isoeth/CcSoM_ADC_Board/README.asciidoc

= README

== Description
CcSoM_ADC_Board is a Baseboard for the  
link:https://github.com/fsnitz/CcSoM[CcSoM]

== Features
CcSoM_ADC_Board main feature is the link:https://www.analog.com/en/products/ltc2242-12.html[LTC2242-12 12Bit ADC]. +
For sending information to the PC the Board includes: +
1x 1Gbit Ethernet (based on link:https://github.com/intergalaktik/Extension_Boards_for_Olimex_GateMate/tree/main/ethIO[Extension_Boards_for_Olimex_GateMate ethIO]) +
2x USB2 Interfaces 

== Manufacturing notes
The signal trace witdth to and from the adc to the connector is calculated for the +
Stackup: JLC041011-3313 (4 Layer, 1 PCBThickness, 1oz inner Copper Weight, 1oz Outer Copper Weight) +
used link:https://jlcpcb.com/pcb-impedance-calculator[calculator] +
50Ohm Single-ended: 0.1427 mm (for gbit ethernet traces) +
100Ohm differential: +
width:0.1016 mm; spacing:0.1524 mm (for ADC traces)

=== Component notes
These Components are discontinued on Digikey: 

* SN74LVC00APWE4 
* TPS73633DBVRG4 

== Project status
schematic and pcb has to be reviewed
