isoeth/CcSoM_ADC_Board/CcSoM_ADC_Board/CcSoM_ADC_Board.kicad_pcb

## KiCad design CcSoM_ADC_Board/CcSoM_ADC_Board.kicad_pcb (2026-04-17)

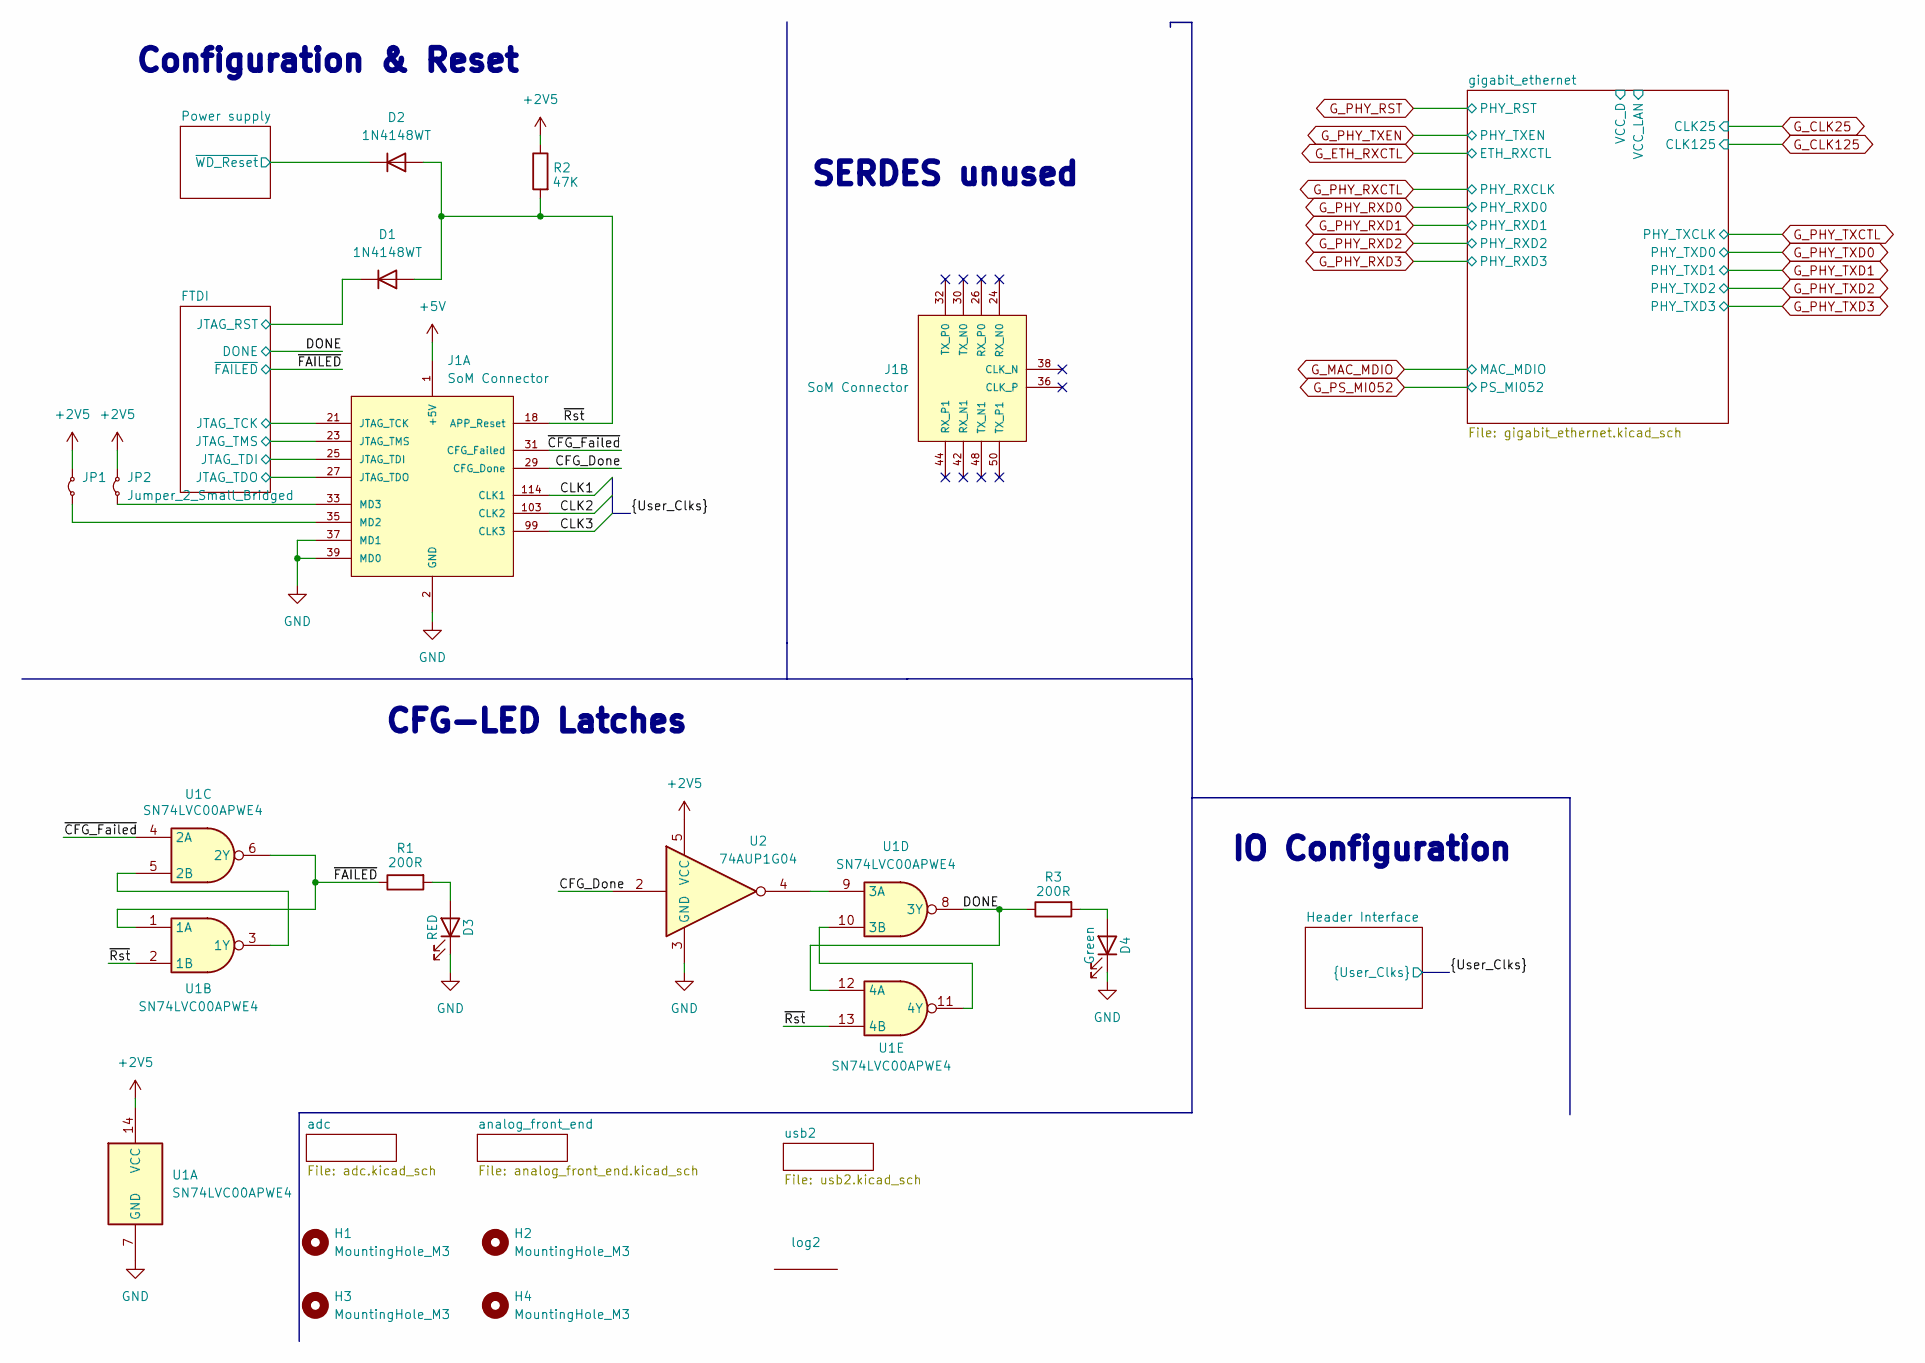
[picture p1: schematic CcSoM_ADC_Board.kicad_sch, SoM Programmer & ADC Board]

Parts:
D1, D2: 1N4148WT; LED_0603_1608Metric; Mouser Part Number 637-1N4148WT
D3: RED; LED_0603_1608Metric; Mouser Part Number 710-150060SS75000
D4: Green; LED_0603_1608Metric; Mouser Part Number 710-150060VS75000
H1, H2, H3, H4: MountingHole_M3; MountingHole_3.2mm_M3
J1: SoM Connector; SoM_Connector; Mouser Part Number 571-1-1473005-1
JP1, JP2: Jumper_2_Small_Bridged; TestPoint_2Pads_Pitch2.54mm_Drill0.8mm; DigiKey_no 664-G800W306018EU-ND
R1, R3: 200R; R_0603_1608Metric; Mouser Part Number 71-CRCW0603200RFKEC
R2: 47K; R_0603_1608Metric; Mouser Part Number 71-CRCW060347K0FKED
U1: SN74LVC00APWE4; TSSOP-14_4.4x5mm_P0.65mm; Mouser Part Number 595-SN74LVC00APWE4
U2: 74AUP1G04; SOT-23-5; Mouser Part Number 595-SN74AUP1G04DBVR
log2: OpenHardwareLogo

Connections:
+5V: J1.1 (+5V), J1.4 (+5V); also elsewhere on the board
/CFG_Done: J1.29 (CFG_Done), U2.2
/CLK1: J1.114 (CLK1)
/CLK2: J1.103 (CLK2)
/CLK3: J1.99 (CLK3)
/DONE: R3.1, U1.8 (3Y), U1.12 (4A); also elsewhere on the board
/FTDI/JTAG_RST: D1.1 (K); also elsewhere on the board
/FTDI/JTAG_TCK: J1.21 (JTAG_TCK); also elsewhere on the board
/FTDI/JTAG_TDI: J1.25 (JTAG_TDI); also elsewhere on the board
/FTDI/JTAG_TDO: J1.27 (JTAG_TDO); also elsewhere on the board
/FTDI/JTAG_TMS: J1.23 (JTAG_TMS); also elsewhere on the board
/Power supply/~WD_Reset: D2.1 (K); also elsewhere on the board
/~CFG_Failed: J1.31 (CFG_Failed), U1.4 (2A)
/~FAILED: R1.1, U1.1 (1A), U1.6 (2Y); also elsewhere on the board
/~Rst: D1.2 (A), D2.2 (A), J1.18 (APP_Reset), R2.2, U1.2 (1B), U1.13 (4B)
unnamed: D3.2 (A), R1.2
unnamed: D4.2 (A), R3.2
unnamed: J1.35 (MD2), JP1.2 (B)
unnamed: J1.33 (MD3), JP2.2 (B)
unnamed: U1.3 (1Y), U1.5 (2B)
unnamed: U1.9 (3A), U2.4
unnamed: U1.10 (3B), U1.11 (4Y)
OGND: D3.1 (K), D4.1 (K), J1.2 (GND), J1.3 (GND), J1.6 (GND), J1.7 (GND), J1.10 (GND), J1.11 (GND), J1.14 (GND), J1.15 (GND), J1.19 (GND), J1.20 (GND), J1.22 (GND), J1.28 (GND), J1.34 (GND), J1.37 (MD1), J1.39 (MD0), J1.40 (GND), J1.46 (GND), J1.52 (GND), J1.54 (GND), J1.97 (GND), J1.101 (GND), J1.105 (GND), J1.112 (GND), J1.116 (GND), J1.122 (GND), J1.144 (GND), J1.159 (GND), J1.162 (GND), J1.180 (GND), J1.181 (GND), J1.199 (GND), J1.S1 (SHIELD), J1.S2 (SHIELD__1), U1.7 (GND), U2.3 (GND); also elsewhere on the board
OVDD: JP1.1 (A), JP2.1 (A), R2.1, U1.14 (VCC), U2.5 (VCC); also elsewhere on the board

Notes on the sheet:
Configuration & Reset
CFG-LED Latches
IO Configuration
SERDES unused

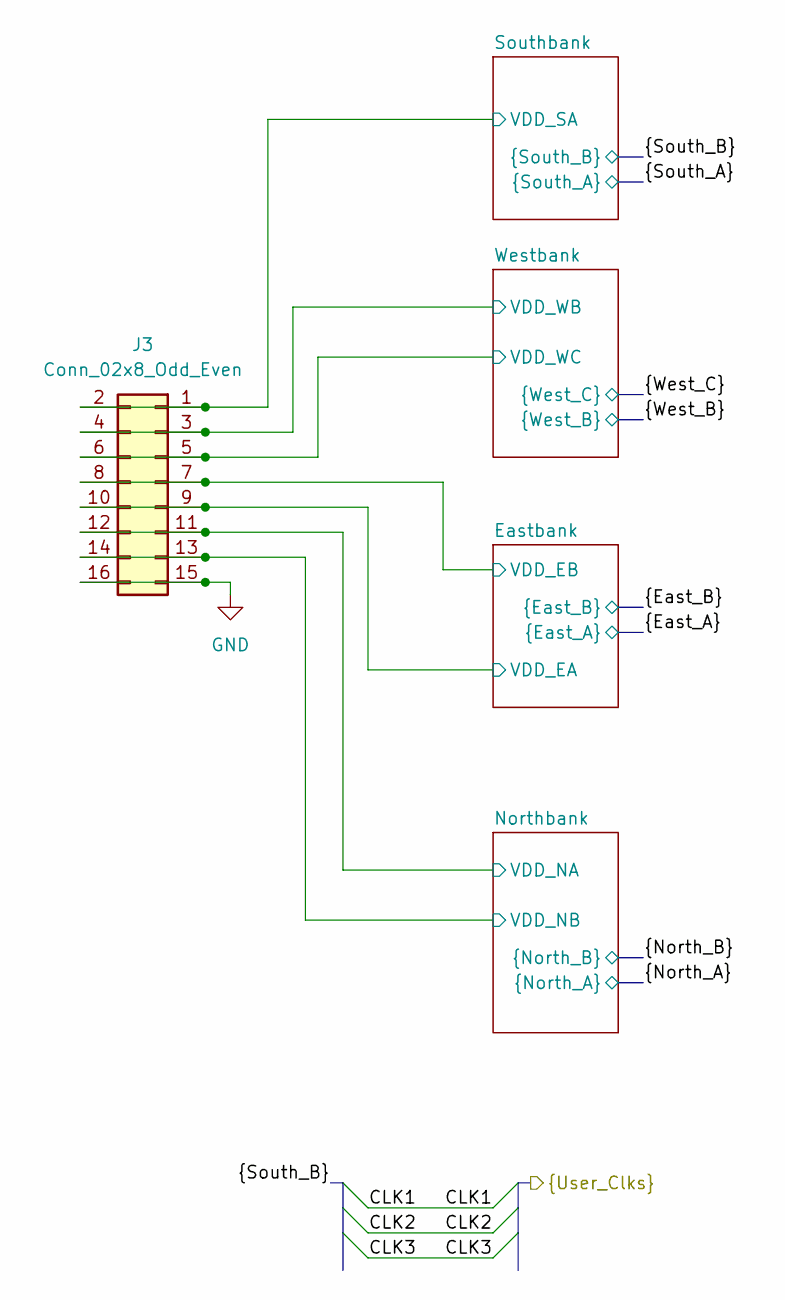
[picture p2: schematic HeaderInterface.kicad_sch, SoM Programmer & ADC Board]

Parts:
J3: Conn_02x8_Odd_Even; PinHeader_2x08_P2.54mm_Vertical; Mouser Part Number 649-1012938191601BLF

Connections:
/Header Interface/Eastbank/VDD_EA: J3.9, J3.10; also elsewhere on the board
/Header Interface/Eastbank/VDD_EB: J3.7, J3.8; also elsewhere on the board
/Header Interface/Northbank/VDD_NA: J3.11, J3.12; also elsewhere on the board
/Header Interface/Northbank/VDD_NB: J3.13, J3.14; also elsewhere on the board
/Header Interface/Southbank/VDD_SA: J3.1, J3.2; also elsewhere on the board
/Header Interface/Westbank/VDD_WB: J3.3, J3.4; also elsewhere on the board
/Header Interface/Westbank/VDD_WC: J3.5, J3.6; also elsewhere on the board
OGND: J3.15, J3.16; also elsewhere on the board

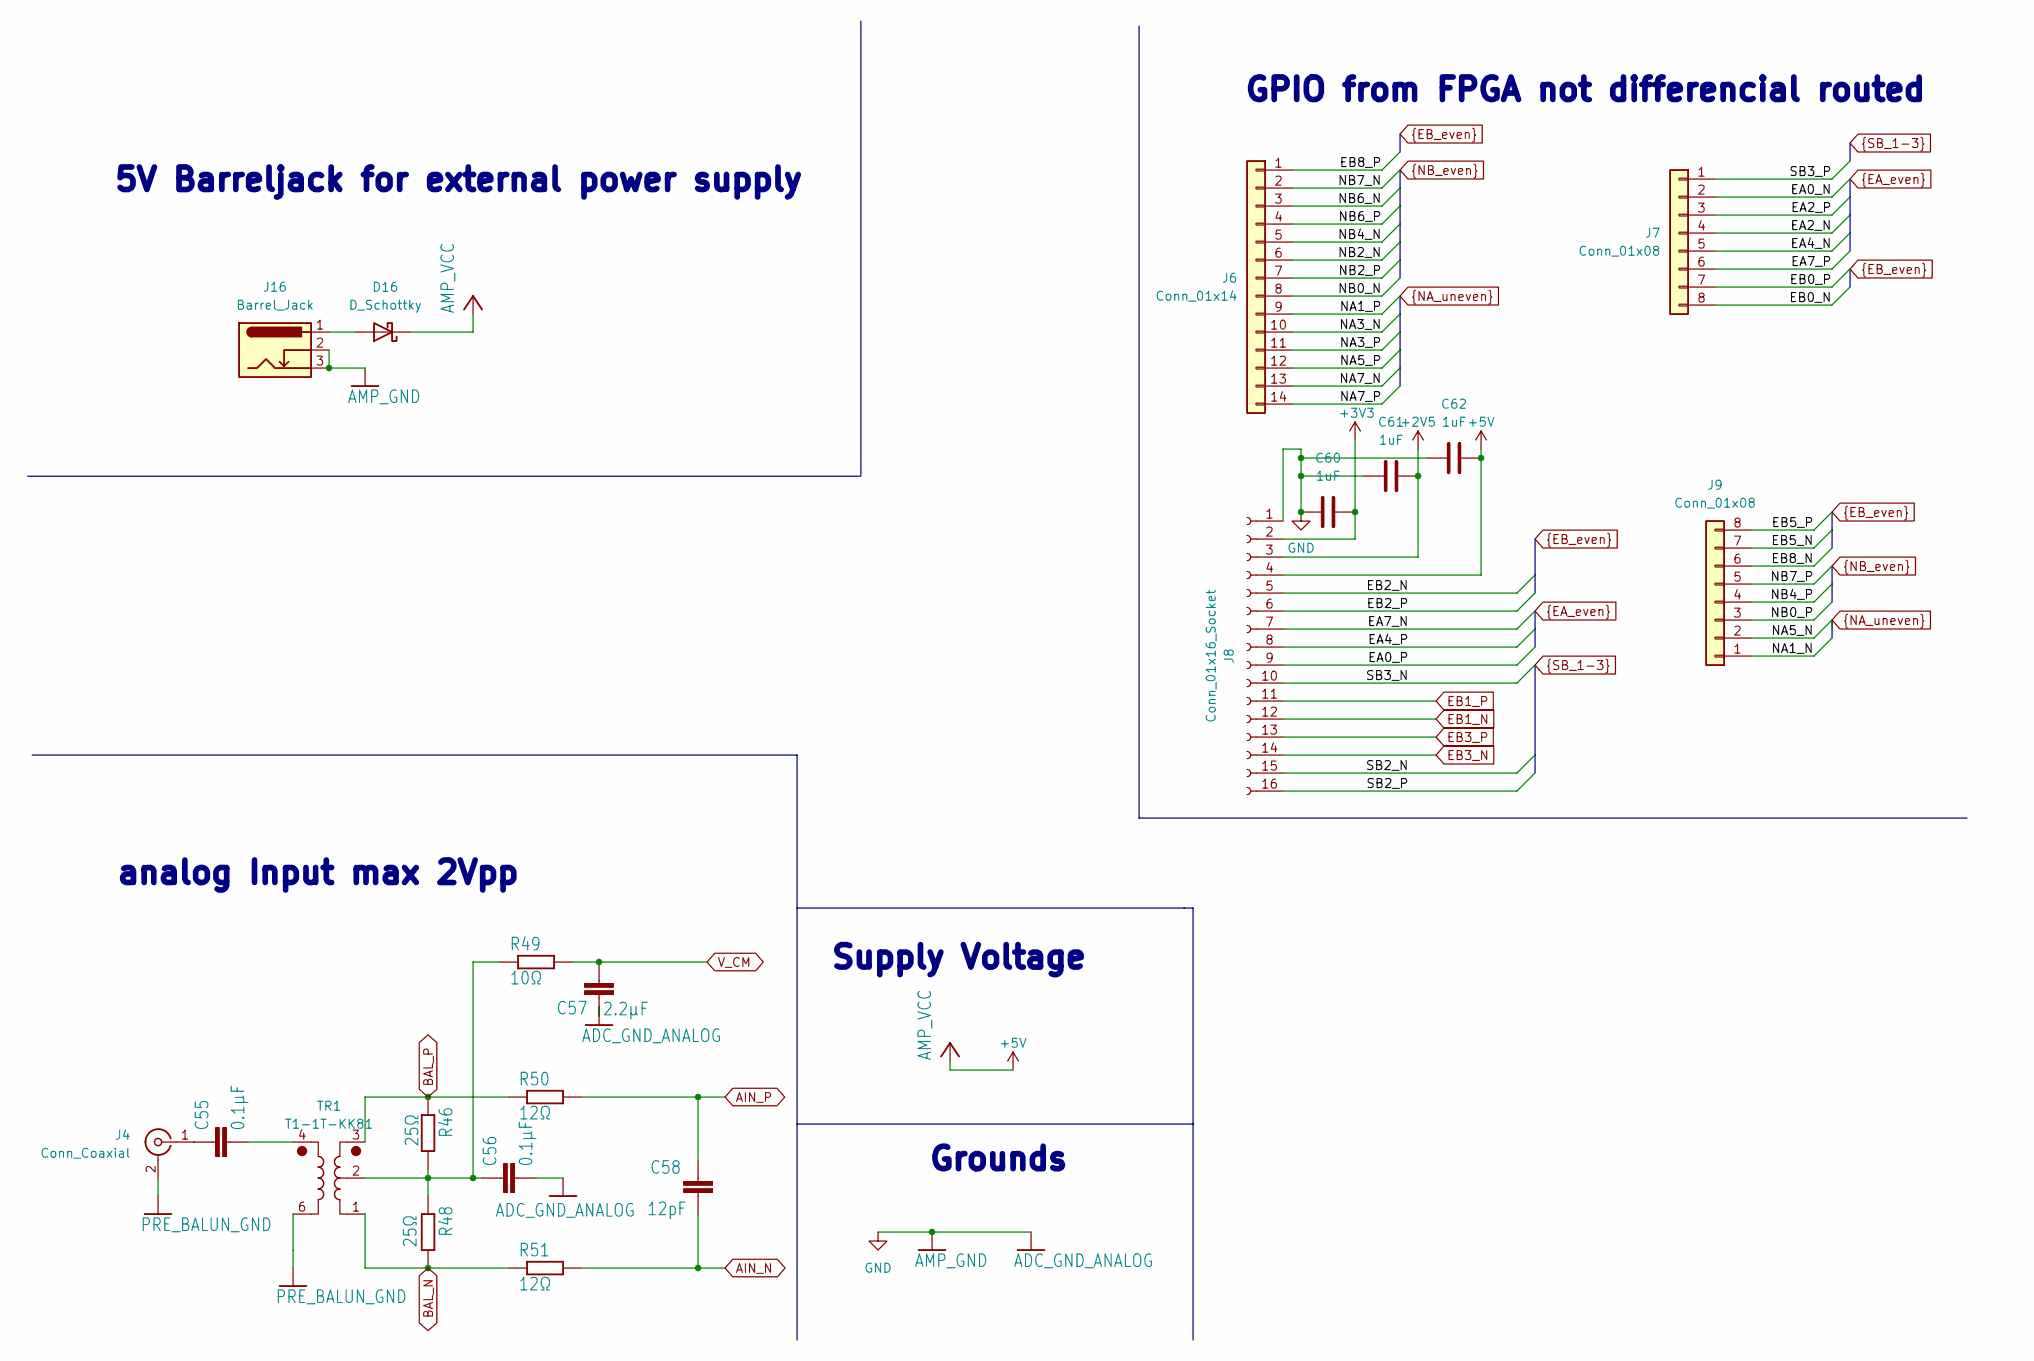
[picture p3: schematic analog_front_end.kicad_sch, SoM Programmer & ADC Board]

Parts:
C55, C56: 0.1μF; C_0402_1005Metric_Pad0.74x0.62mm_HandSolder; DigiKey_no C0402C104K4RACTU
C57: 2.2μF; C_0402_1005Metric_Pad0.74x0.62mm_HandSolder; DigiKey_no 490-10012-1-ND
C58: 12pF; C_0402_1005Metric_Pad0.74x0.62mm_HandSolder; DigiKey_no 399-C0402C120J5GACTUCT-ND
C60, C61, C62: 1uF; C_0603_1608Metric; Mouser Part Number 80-C0603C104M4R7411
D16: D_Schottky; D_0805_2012Metric_Pad1.15x1.40mm_HandSolder; DigiKey_no 478-7800-1-ND
J4: Conn_Coaxial; SMA_Amphenol_132134-11_Vertical; DigiKey_no ACX1995-ND
J6: Conn_01x14; PinSocket_1x14_P2.54mm_Vertical; DigiKey_no S7012-ND
J7, J9: Conn_01x08; PinSocket_1x08_P2.54mm_Vertical; DigiKey_no S7006-ND
J8: Conn_01x16_Socket; PinSocket_1x16_P2.54mm_Vertical; DigiKey_no S7014-ND
J16: Barrel_Jack; BarrelJack_CLIFF_FC681465S_SMT_Horizontal; DigiKey_no 4654-FC681465S-ND
R46, R48: 25Ω; R_0402_1005Metric_Pad0.72x0.64mm_HandSolder; DigiKey_no 478-UBR0402B250FZTR\500CT-ND
R49: 10Ω; R_0402_1005Metric_Pad0.72x0.64mm_HandSolder; DigiKey_no 541-10.0LCT-ND
R50, R51: 12Ω; R_0402_1005Metric_Pad0.72x0.64mm_HandSolder; DigiKey_no YAG2968CT-ND
TR1: T1-1T-KK81; DigiKey_no 3157-T1-1T-KK81+CT-ND

Connections:
+3V3: C60.2, J8.2; also elsewhere on the board
+5V: C62.2, D16.1 (K), J8.4; also elsewhere on the board
AIN_N: C58.1, R51.2; also elsewhere on the board
AIN_P: C58.2, R50.2; also elsewhere on the board
BAL_N: R48.2, R51.1, TR1.1
BAL_P: R46.1, R50.1, TR1.3
EA0_N: J7.2; also elsewhere on the board
EA0_P: J8.9; also elsewhere on the board
EA2_N: J7.4; also elsewhere on the board
EA2_P: J7.3; also elsewhere on the board
EA4_N: J7.5; also elsewhere on the board
EA4_P: J8.8; also elsewhere on the board
EA7_N: J8.7; also elsewhere on the board
EA7_P: J7.6; also elsewhere on the board
EB0_N: J7.8; also elsewhere on the board
EB0_P: J7.7; also elsewhere on the board
EB1_N: J8.12; also elsewhere on the board
EB1_P: J8.11; also elsewhere on the board
EB2_N: J8.5; also elsewhere on the board
EB2_P: J8.6; also elsewhere on the board
EB3_N: J8.14; also elsewhere on the board
EB3_P: J8.13; also elsewhere on the board
EB5_N: J9.7; also elsewhere on the board
EB5_P: J9.8; also elsewhere on the board
EB8_N: J9.6; also elsewhere on the board
EB8_P: J6.1; also elsewhere on the board
NA1_N: J9.1; also elsewhere on the board
NA1_P: J6.9; also elsewhere on the board
NA3_N: J6.10; also elsewhere on the board
NA3_P: J6.11; also elsewhere on the board
NA5_N: J9.2; also elsewhere on the board
NA5_P: J6.12; also elsewhere on the board
NA7_N: J6.13; also elsewhere on the board
NA7_P: J6.14; also elsewhere on the board
NB0_N: J6.8; also elsewhere on the board
NB0_P: J9.3; also elsewhere on the board
NB2_N: J6.6; also elsewhere on the board
NB2_P: J6.7; also elsewhere on the board
NB4_N: J6.5; also elsewhere on the board
NB4_P: J9.4; also elsewhere on the board
NB6_N: J6.3; also elsewhere on the board
NB6_P: J6.4; also elsewhere on the board
NB7_N: J6.2; also elsewhere on the board
NB7_P: J9.5; also elsewhere on the board
unnamed: C55.2, TR1.4
unnamed: C56.1, R46.2, R48.1, R49.1, TR1.2
unnamed: D16.2 (A), J16.1
unnamed: C55.1, J4.1 (In)
OGND: C56.2, C57.1, C60.1, C61.1, C62.1, J8.1, J16.2, J16.3; also elsewhere on the board
OVDD: C61.2, J8.3; also elsewhere on the board
PRE_BALUN_GND: J4.2 (Ext), TR1.6
SB2_N: J8.15; also elsewhere on the board
SB2_P: J8.16; also elsewhere on the board
SB3_N: J8.10; also elsewhere on the board
SB3_P: J7.1; also elsewhere on the board
V_CM: C57.2, R49.2; also elsewhere on the board

Notes on the sheet:
GPIO from FPGA not differencial routed
Supply Voltage
analog Input max 2Vpp
5V Barreljack for external power supply
Grounds

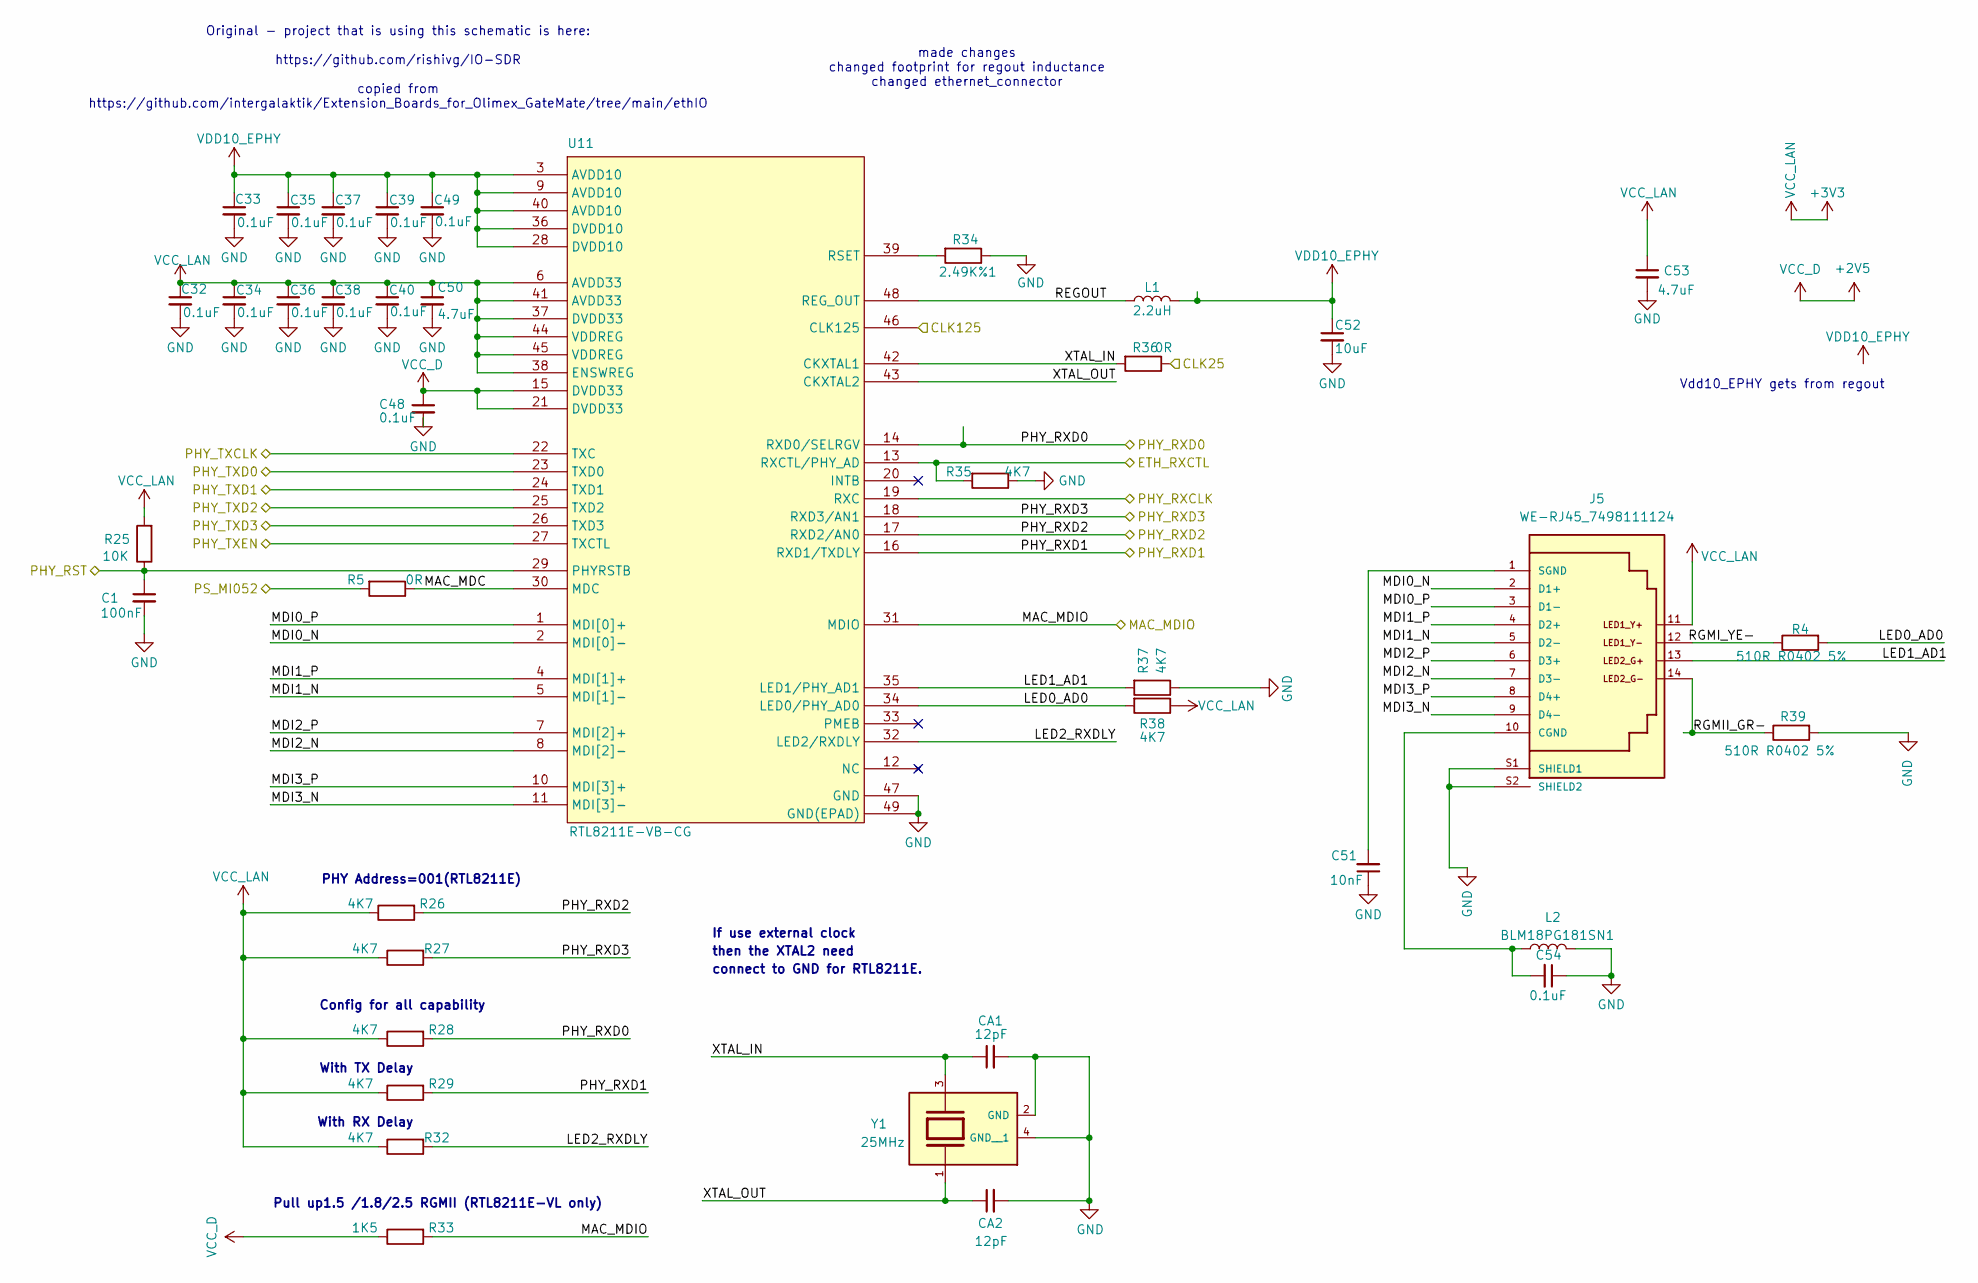
[picture p4: schematic gigabit_ethernet.kicad_sch, Olimex Extension ethIO v0.1]

Parts:
C1: 100nF; C_0402_1005Metric_Pad0.74x0.62mm_HandSolder; DigiKey_no 1276-CL05B104KP5VPNCCT-ND
C32, C33, C34, C35, C36, C37, C38, C39, C40, C48, C49: 0.1uF; C_0402_1005Metric_Pad0.74x0.62mm_HandSolder; DigiKey_no 399-C0402C104K4RACTUCT-ND
C50, C53: 4.7uF; C_0603_1608Metric_Pad1.08x0.95mm_HandSolder; DigiKey_no 490-7203-1-ND
C51: 10nF; C_0402_1005Metric_Pad0.74x0.62mm_HandSolder; DigiKey_no 399-C0402C103K4RACTUCT-ND
C52: 10uF; C_0805_2012Metric_Pad1.18x1.45mm_HandSolder; DigiKey_no 478-KGM21AR50J106KUCT-ND
C54: 0.1uF; C_0805_2012Metric_Pad1.18x1.45mm_HandSolder; DigiKey_no 478-KGM21NR71E104KTCT-ND
CA1, CA2: 12pF; C_0402_1005Metric_Pad0.74x0.62mm_HandSolder; DigiKey_no 399-C0402C120J5GACTUCT-ND
J5: WE-RJ45_7498111124; 7498111124; DigiKey_no 732-7498111124CT-ND
L1: 2.2uH; L_0805_2012Metric_Pad1.05x1.20mm_HandSolder; DigiKey_no 535-AOTA-B201210S2R2MTCT-ND
L2: BLM18PG181SN1; L_0603_1608Metric_Pad1.05x0.95mm_HandSolder; DigiKey_no 490-5263-1-ND
R4, R39: 510R R0402 5%; R_0402_1005Metric_Pad0.72x0.64mm_HandSolder; DigiKey_no 2019-RK73B1ETTP511JCT-ND
R5: 0R; R_0603_1608Metric_Pad0.98x0.95mm_HandSolder; DigiKey_no 311-0.0GRCT-ND
R25: 10K; R_0402_1005Metric_Pad0.72x0.64mm_HandSolder; DigiKey_no 541-10.0KLCT-ND
R26, R27, R28, R29, R32, R35, R37, R38: 4K7; R_0402_1005Metric_Pad0.72x0.64mm_HandSolder; DigiKey_no 541-4.70KLCT-ND
R33: 1K5; R_0402_1005Metric_Pad0.72x0.64mm_HandSolder; DigiKey_no 541-1.50KLCT-ND
R34: 2.49K%1; R_0402_1005Metric_Pad0.72x0.64mm_HandSolder; DigiKey_no 541-2.49KLCT-ND
R36: 0R; R_0402_1005Metric_Pad0.72x0.64mm_HandSolder; DigiKey_no 541-0.0JCT-ND
U11: RTL8211E-VB-CG; DigiKey_no 1188-SMDICRTL8211E-VB-CG-ND
Y1: 25MHz; Crystal_SMD_SeikoEpson_TSX3225-4Pin_3.2x2.5mm; PARTREV N/A; DigiKey_no SER4211CT-ND

Connections:
+3V3: C32.1, C34.1, C36.1, C38.1, C40.1, C50.1, C53.1, J5.11, R25.2, R26.1, R27.1, R28.1, R29.1, R32.1, R38.1, U11.6 (AVDD33), U11.37 (DVDD33), U11.38 (ENSWREG), U11.41 (AVDD33), U11.44 (VDDREG), U11.45 (VDDREG); also elsewhere on the board
/gigabit_ethernet/LED0_AD0: R4.2, R38.2, U11.34 (LED0/PHY_AD0)
/gigabit_ethernet/LED1_AD1: J5.13, R37.2, U11.35 (LED1/PHY_AD1)
/gigabit_ethernet/LED2_RXDLY: R32.2, U11.32 (LED2/RXDLY)
/gigabit_ethernet/MAC_MDC: R5.1, U11.30 (MDC)
/gigabit_ethernet/MDI0_N: J5.2 (D1+), U11.2 (MDI[0]-)
/gigabit_ethernet/MDI0_P: J5.3 (D1-), U11.1 (MDI[0]+)
/gigabit_ethernet/MDI1_N: J5.5 (D2-), U11.5 (MDI[1]-)
/gigabit_ethernet/MDI1_P: J5.4 (D2+), U11.4 (MDI[1]+)
/gigabit_ethernet/MDI2_N: J5.7 (D3-), U11.8 (MDI[2]-)
/gigabit_ethernet/MDI2_P: J5.6 (D3+), U11.7 (MDI[2]+)
/gigabit_ethernet/MDI3_N: J5.9 (D4-), U11.11 (MDI[3]-)
/gigabit_ethernet/MDI3_P: J5.8 (D4+), U11.10 (MDI[3]+)
/gigabit_ethernet/REGOUT: L1.1, U11.48 (REG_OUT)
/gigabit_ethernet/RGMII_GR-: J5.14, R39.1
/gigabit_ethernet/RGMI_YE-: J5.12, R4.1
/gigabit_ethernet/XTAL_IN: CA1.1, R36.2, U11.42 (CKXTAL1), Y1.3
/gigabit_ethernet/XTAL_OUT: CA2.1, U11.43 (CKXTAL2), Y1.1
G_CLK25: R36.1; also elsewhere on the board
G_CLK125: U11.46 (CLK125); also elsewhere on the board
G_ETH_RXCTL: R35.2, U11.13 (RXCTL/PHY_AD); also elsewhere on the board
G_MAC_MDIO: R33.2, U11.31 (MDIO); also elsewhere on the board
G_PHY_RST: C1.1, R25.1, U11.29 (PHYRSTB); also elsewhere on the board
G_PHY_RXCTL: U11.19 (RXC); also elsewhere on the board
G_PHY_RXD0: R28.2, U11.14 (RXD0/SELRGV); also elsewhere on the board
G_PHY_RXD1: R29.2, U11.16 (RXD1/TXDLY); also elsewhere on the board
G_PHY_RXD2: R26.2, U11.17 (RXD2/AN0); also elsewhere on the board
G_PHY_RXD3: R27.2, U11.18 (RXD3/AN1); also elsewhere on the board
G_PHY_TXCTL: U11.22 (TXC); also elsewhere on the board
G_PHY_TXD0: U11.23 (TXD0); also elsewhere on the board
G_PHY_TXD1: U11.24 (TXD1); also elsewhere on the board
G_PHY_TXD2: U11.25 (TXD2); also elsewhere on the board
G_PHY_TXD3: U11.26 (TXD3); also elsewhere on the board
G_PHY_TXEN: U11.27 (TXCTL); also elsewhere on the board
G_PS_MI052: R5.2; also elsewhere on the board
unnamed: C54.2, J5.10 (CGND), L2.2
unnamed: C51.2, J5.1 (SGND)
unnamed: R34.2, U11.39 (RSET)
OGND: C1.2, C32.2, C33.2, C34.2, C35.2, C36.2, C37.2, C38.2, C39.2, C40.2, C48.2, C49.2, C50.2, C51.1, C52.2, C53.2, C54.1, CA1.2, CA2.2, J5.S1 (SHIELD1), J5.S2 (SHIELD2), L2.1, R34.1, R35.1, R37.1, R39.2, U11.47 (GND), U11.49 (GND(EPAD)), Y1.2 (GND), Y1.4 (GND__1); also elsewhere on the board
OVDD: C48.1, R33.1, U11.15 (DVDD33), U11.21 (DVDD33); also elsewhere on the board
VDD10_EPHY: C33.1, C35.1, C37.1, C39.1, C49.1, C52.1, L1.2, U11.3 (AVDD10), U11.9 (AVDD10), U11.28 (DVDD10), U11.36 (DVDD10), U11.40 (AVDD10)

Notes on the sheet:
Original - project that is using this schematic is here: https://github.com/rishivg/IO-SDR copied from https://github.com/intergalaktik/Extension_Boards_for_Olimex_GateMate/tree/main/ethIO
Config for all capability
With TX Delay
Pull up1.5 /1.8/2.5 RGMII (RTL8211E-VL only)
Vdd10_EPHY gets from regout
then the XTAL2 need
connect to GND for RTL8211E.
made changes changed footprint for regout inductance changed ethernet_connector
If use external clock
PHY Address=001(RTL8211E)
With RX Delay

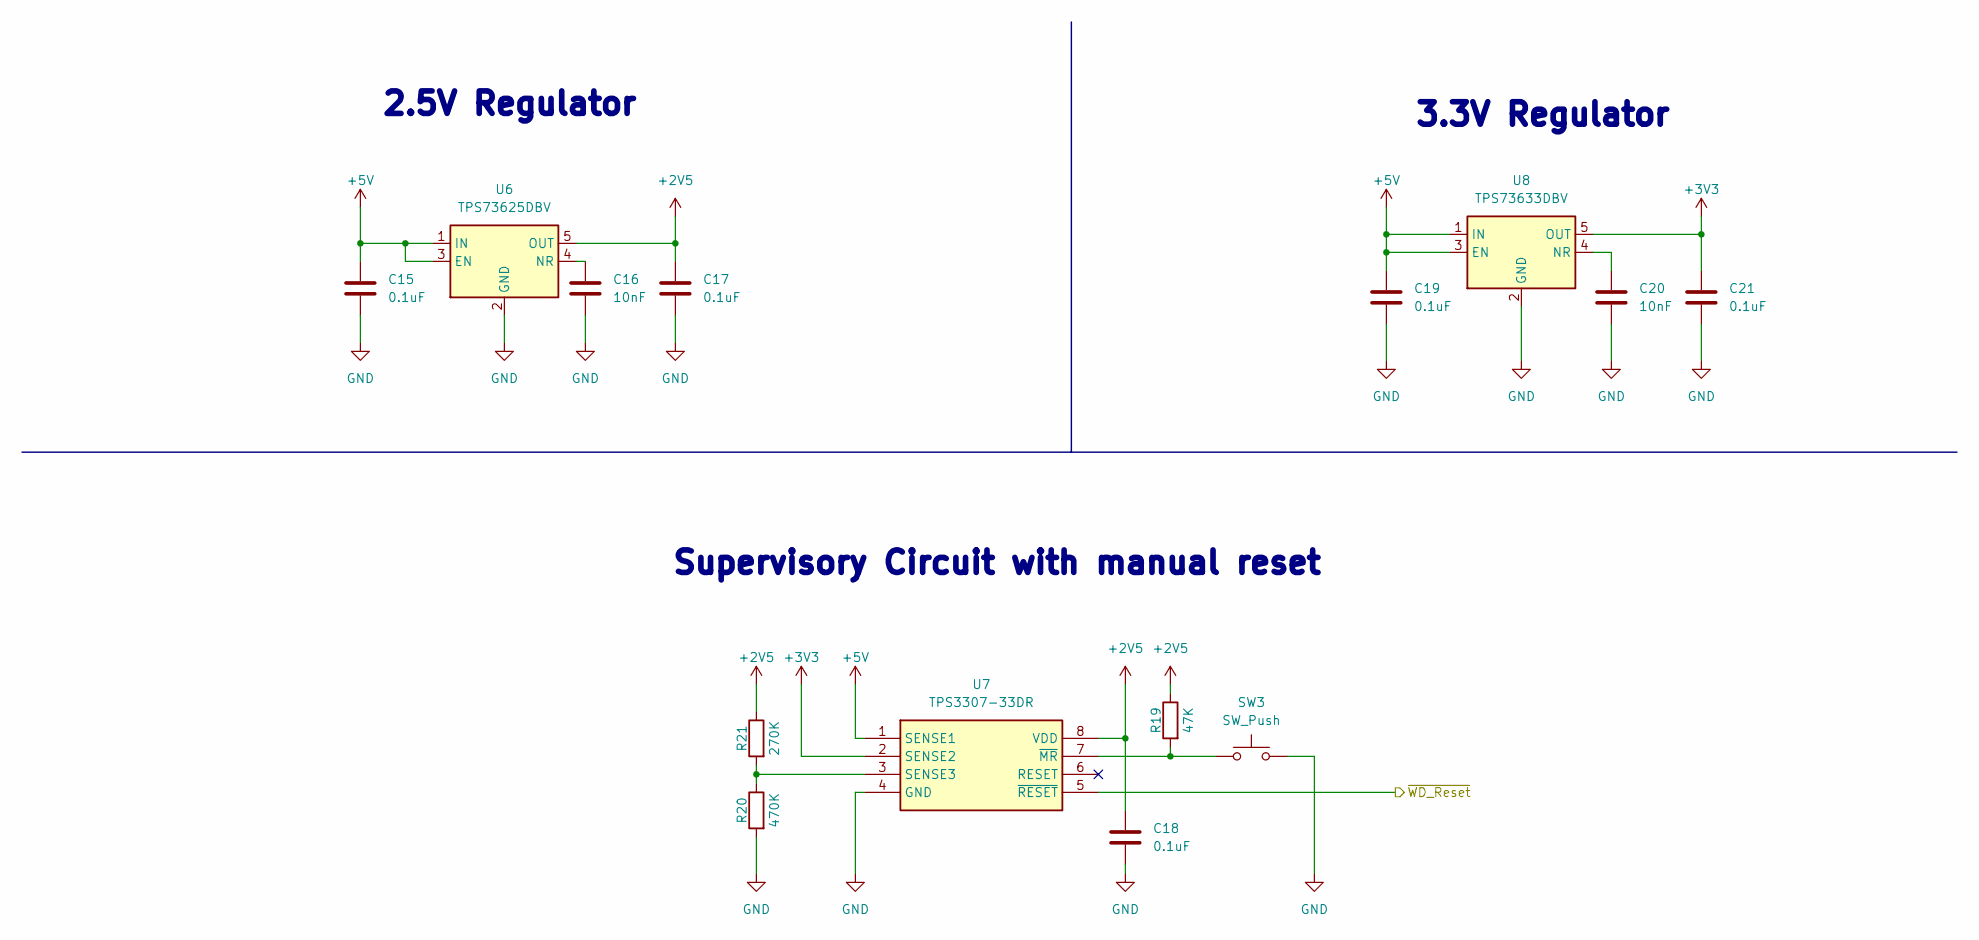
[picture p5: schematic PowerSupply.kicad_sch, SoM Programmer & ADC]

Parts:
C15, C17, C18, C19, C21: 0.1uF; C_0603_1608Metric; Mouser Part Number 80-C0603C104M4R7411
C16, C20: 10nF; C_0603_1608Metric; Mouser Part Number 80-C0603X103J4HAUTO
R19: 47K; R_0603_1608Metric; Mouser Part Number 71-CRCW060347K0FKED
R20: 470K; R_0603_1608Metric; Mouser Part Number 71-CRCW0603470KFKEAH
R21: 270K; R_0603_1608Metric; Mouser Part Number 71-CRCW0603-270K-E3
SW3: SW_Push; SW_SPST_TL3305A; Mouser Part Number 612-TL3305AF260QG
U6: TPS73625DBV; SOT-23-5; Mouser Part Number 595-TPS73625DBVT
U7: TPS3307-33DR; SOIC-8_5.8x3.81mm; Mouser Part Number 595-TPS3307-33DR
U8: TPS73633DBV; SOT-23-5; Mouser Part Number 595-TPS73633DBVRG4

Connections:
+3V3: C21.1, U7.2 (SENSE2), U8.5 (OUT); also elsewhere on the board
+5V: C15.1, C19.1, U6.1 (IN), U6.3 (EN), U7.1 (SENSE1), U8.1 (IN), U8.3 (EN); also elsewhere on the board
/Power supply/~WD_Reset: U7.5 (~RESET); also elsewhere on the board
unnamed: C16.1, U6.4 (NR)
unnamed: R20.1, R21.2, U7.3 (SENSE3)
unnamed: R19.2, SW3.1, U7.7 (~MR)
unnamed: C20.1, U8.4 (NR)
OGND: C15.2, C16.2, C17.2, C18.2, C19.2, C20.2, C21.2, R20.2, SW3.2, U6.2 (GND), U7.4 (GND), U8.2 (GND); also elsewhere on the board
OVDD: C17.1, C18.1, R19.1, R21.1, U6.5 (OUT), U7.8 (VDD); also elsewhere on the board

Notes on the sheet:
Supervisory Circuit with manual reset
3.3V Regulator
2.5V Regulator

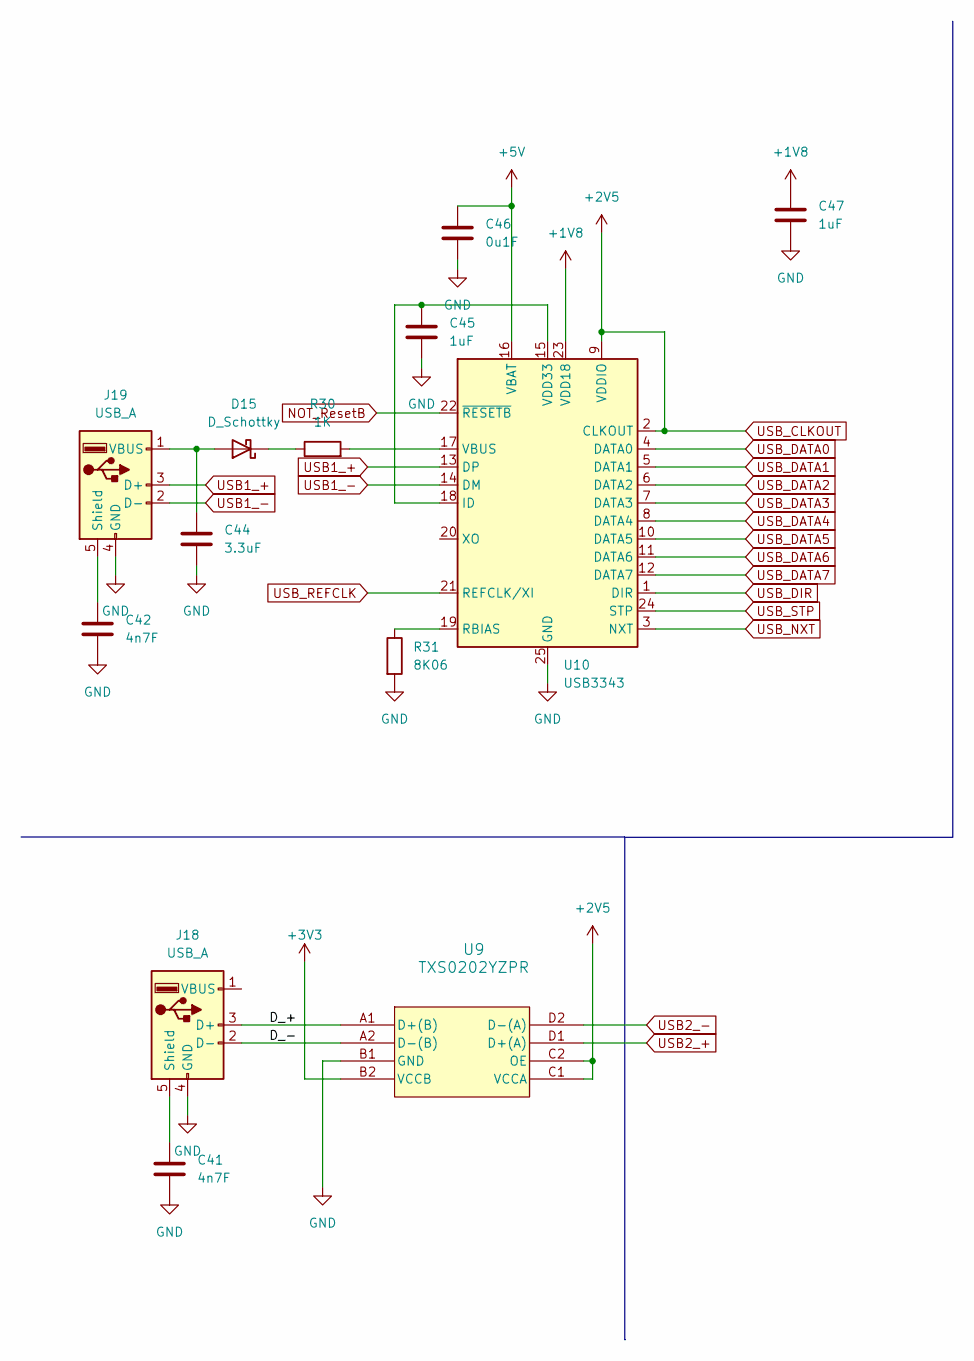
[picture p6: schematic usb2.kicad_sch, SoM Programmer & ADC Board]

Parts:
C41, C42: 4n7F; C_0603_1608Metric; DigiKey_no 399-C0603C472K5RACTUCT-ND
C44: 3.3uF; C_0603_1608Metric; DigiKey_no 399-3481-1-ND
C45, C47: 1uF; C_0603_1608Metric; DigiKey_no 399-C0603C105K4RACTUCT-ND
C46: 0u1F; C_0603_1608Metric; DigiKey_no 311-1088-1-ND
D15: D_Schottky; D_0805_2012Metric_Pad1.15x1.40mm_HandSolder; DigiKey_no 478-7800-1-ND
J18, J19: USB_A; USB_A_Stewart_SS-52100-001_Horizontal; DigiKey_no 380-1412-ND
R30: 1K; R_0603_1608Metric; DigiKey_no RMCF0603FT1K00CT-ND
R31: 8K06; R_0603_1608Metric; DigiKey_no 541-8.06KHCT-ND
U9: TXS0202YZPR; YZP8; Mouser Part Number 595-TXS0202YZPR; DigiKey_no 296-29072-1-ND
U10: USB3343; QFN-24-1EP_4x4mm_P0.5mm_EP2.6x2.6mm; DigiKey_no 638-1116-1-ND

Connections:
+1V8: C47.1, U10.23 (VDD18)
+3V3: U9.B2 (VCCB); also elsewhere on the board
+5V: C46.1, U10.16 (VBAT); also elsewhere on the board
/usb2/D_+: J18.3 (D+), U9.A1 (D+(B))
/usb2/D_-: J18.2 (D-), U9.A2 (D-(B))
NOT_ResetB: U10.22 (~RESETB); also elsewhere on the board
unnamed: C44.1, D15.2 (A), J19.1 (VBUS)
unnamed: D15.1 (K), R30.1
unnamed: C41.1, J18.5 (Shield)
unnamed: C42.1, J19.5 (Shield)
unnamed: C45.1, U10.15 (VDD33), U10.18 (ID)
unnamed: R31.1, U10.19 (RBIAS)
unnamed: R30.2, U10.17 (VBUS)
OGND: C41.2, C42.2, C44.2, C45.2, C46.2, C47.2, J18.4 (GND), J19.4 (GND), R31.2, U9.B1 (GND), U10.25 (GND); also elsewhere on the board
OVDD: U9.C1 (VCCA), U9.C2 (OE), U10.2 (CLKOUT), U10.9 (VDDIO); also elsewhere on the board
USB1_+: J19.3 (D+), U10.13 (DP)
USB1_-: J19.2 (D-), U10.14 (DM)
USB2_+: U9.D1 (D+(A)); also elsewhere on the board
USB2_-: U9.D2 (D-(A)); also elsewhere on the board
USB_DATA0: U10.4 (DATA0); also elsewhere on the board
USB_DATA1: U10.5 (DATA1); also elsewhere on the board
USB_DATA2: U10.6 (DATA2); also elsewhere on the board
USB_DATA3: U10.7 (DATA3); also elsewhere on the board
USB_DATA4: U10.8 (DATA4); also elsewhere on the board
USB_DATA5: U10.10 (DATA5); also elsewhere on the board
USB_DATA6: U10.11 (DATA6); also elsewhere on the board
USB_DATA7: U10.12 (DATA7); also elsewhere on the board
USB_DIR: U10.1 (DIR); also elsewhere on the board
USB_NXT: U10.3 (NXT); also elsewhere on the board
USB_REFCLK: U10.21 (REFCLK/XI); also elsewhere on the board
USB_STP: U10.24 (STP); also elsewhere on the board
