isoeth/CcSoM_ADC_Board/CcSoM_ADC_Board/CcSoM_ADC_Board.kicad_pcb

## KiCad design CcSoM_ADC_Board/CcSoM_ADC_Board.kicad_pcb (continued)

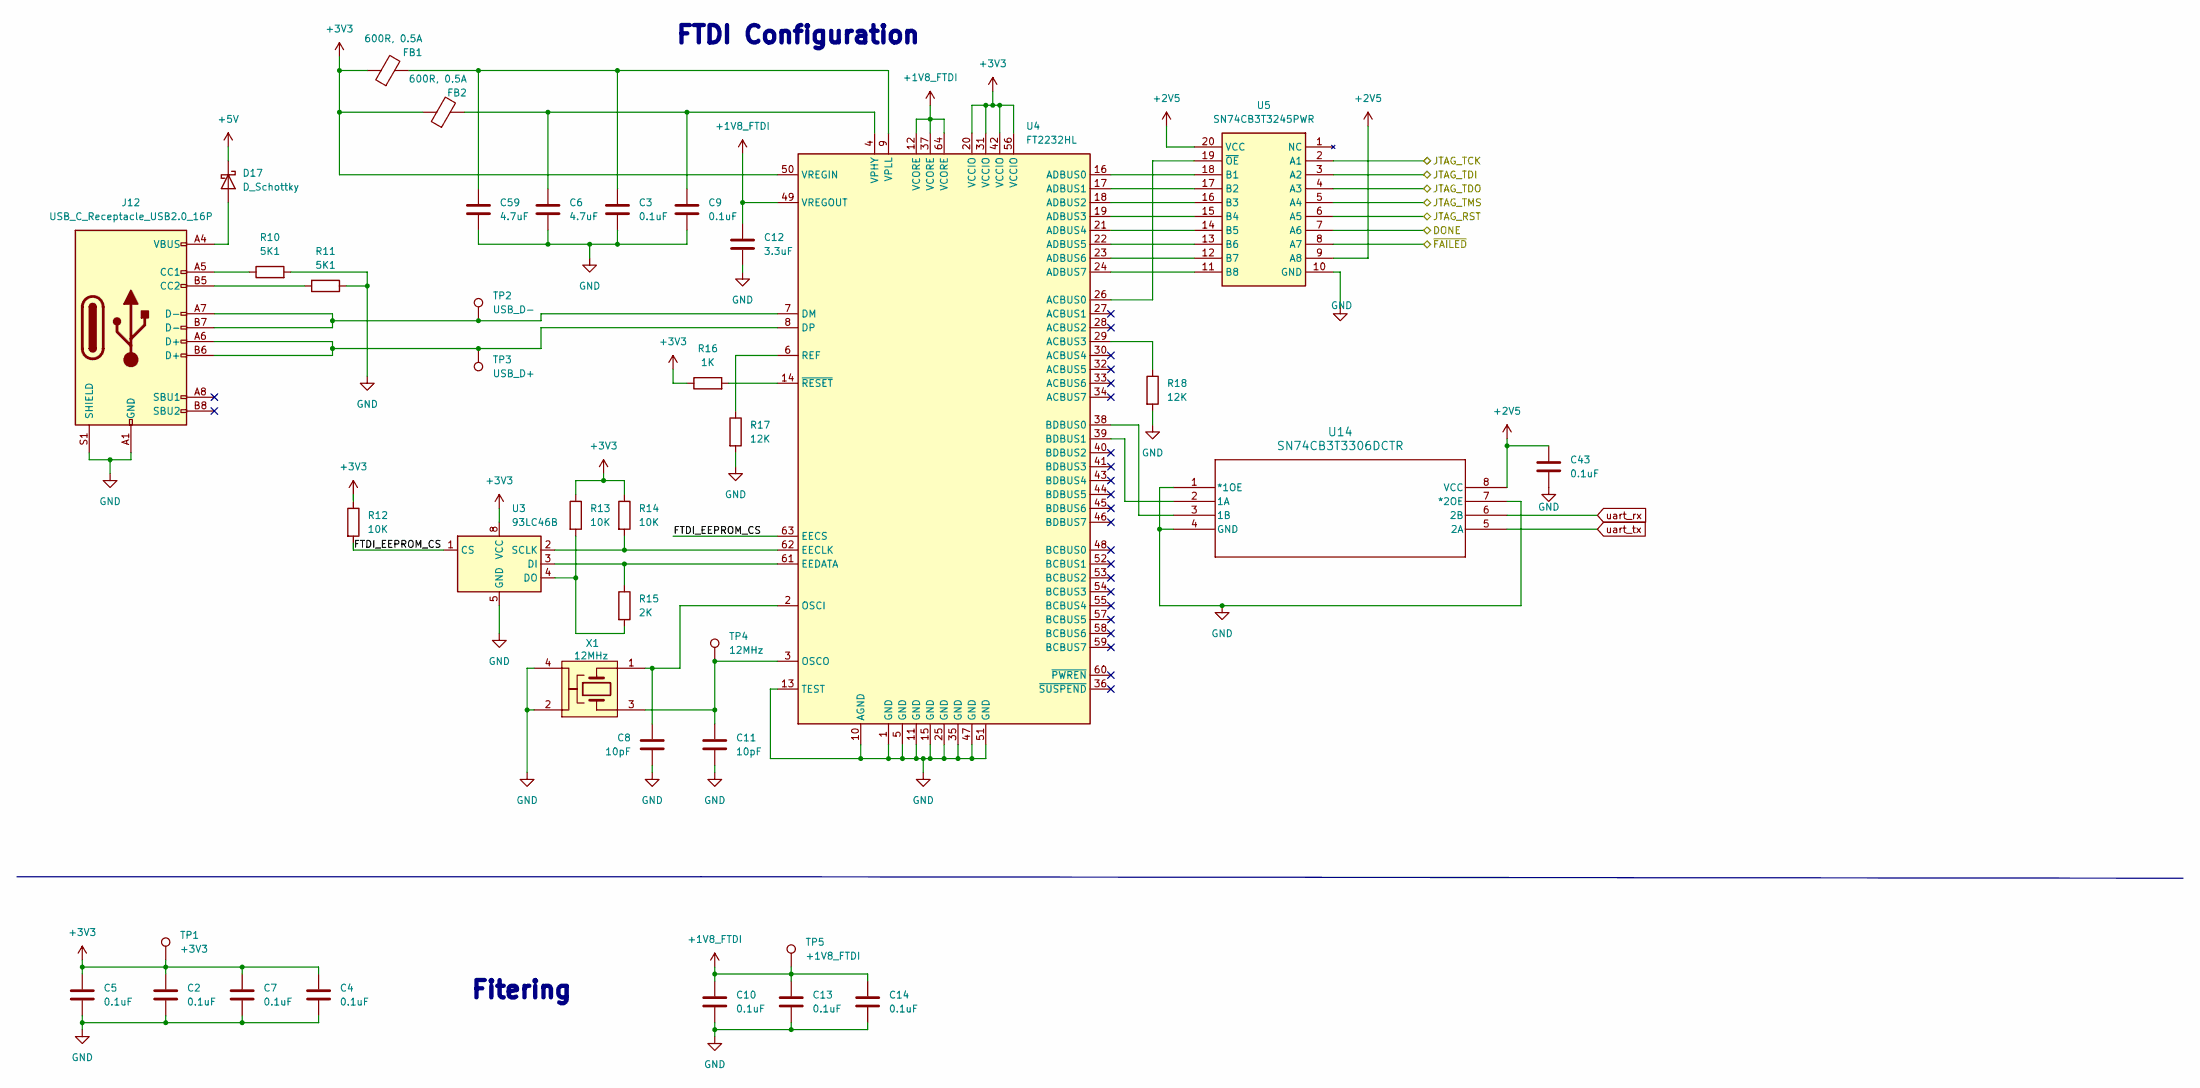
[picture p7: schematic FTDI.kicad_sch, SoM Programmer & Tester]

Parts:
C2, C3, C4, C5, C7, C9, C10, C13, C14, C43: 0.1uF; C_0603_1608Metric; Mouser Part Number 80-C0603C104M4R7411
C6, C59: 4.7uF; C_0603_1608Metric; Mouser Part Number 963-MSASE168AB5475KT
C8, C11: 10pF; C_0603_1608Metric; Mouser Part Number 581-0603YA100JAT2A
C12: 3.3uF; C_0603_1608Metric; Mouser Part Number 810-C1608X5R1C335KAC
D17: D_Schottky; D_0805_2012Metric_Pad1.15x1.40mm_HandSolder; DigiKey_no 478-7800-1-ND
FB1, FB2: 600R, 0.5A; L_0603_1608Metric; Mouser Part Number 810-MMZ1608R601ATD25
J12: USB_C_Receptacle_USB2.0_16P; USB_C_Receptacle_GCT_USB4110; Mouser Part Number 640-USB4110-GF-A
R10, R11: 5K1; R_0603_1608Metric; Mouser Part Number 71-RCS060356K0FKEA
R12, R13, R14: 10K; R_0603_1608Metric; Mouser Part Number 71-CRCW060310K0FKED
R15: 2K; R_0603_1608Metric; Mouser Part Number 71-TNPW06032K00FHEA
R16: 1K; R_0603_1608Metric; Mouser Part Number 71-CRCW0603-1.0K-E3
R17, R18: 12K; R_0603_1608Metric; Mouser Part Number 71-CRCW0603-12K-E3
TP1: +3V3; TestPoint_Pad_D1.5mm
TP2: USB_D-; TestPoint_Pad_D1.5mm
TP3: USB_D+; TestPoint_Pad_D1.5mm
TP4: 12MHz; TestPoint_Pad_D1.5mm
TP5: +1V8_FTDI; TestPoint_Pad_D1.5mm
U3: 93LC46B; TSSOP-8_4.4x3mm_P0.65mm; Mouser Part Number 579-93LC46BT-E/ST
U4: FT2232HL; LQFP-64_10x10mm_P0.5mm; Mouser Part Number 895-FT2232HL
U5: SN74CB3T3245PWR; TSSOP-20_4.4x6.5mm_P0.65mm; Mouser Part Number 595-SN74CB3T3245PWR
U14: SN74CB3T3306DCTR; DCT8; DigiKey_no 296-15553-1-ND
X1: 12MHz; Crystal_SMD_Abracon_ABM3B-4Pin_5.0x3.2mm; Mouser Part Number 815-ABM3B-12-T

Connections:
+1V8_FTDI: C10.1, C12.1, C13.1, C14.1, TP5.1 (1_1), U4.12 (VCORE), U4.37 (VCORE), U4.49 (VREGOUT), U4.64 (VCORE)
+3V3: C2.1, C4.1, C5.1, C7.1, FB1.1, FB2.1, R12.1, R13.1, R14.1, R16.1, TP1.1 (1_1), U3.8 (VCC), U4.20 (VCCIO), U4.31 (VCCIO), U4.42 (VCCIO), U4.50 (VREGIN), U4.56 (VCCIO); also elsewhere on the board
+5V: D17.1 (K); also elsewhere on the board
/DONE: U5.7 (A6); also elsewhere on the board
/FTDI/FTDI_EEPROM_CS: R12.2, U3.1 (CS), U4.63 (EECS)
/FTDI/JTAG_RST: U5.6 (A5); also elsewhere on the board
/FTDI/JTAG_TCK: U5.2 (A1); also elsewhere on the board
/FTDI/JTAG_TDI: U5.3 (A2); also elsewhere on the board
/FTDI/JTAG_TDO: U5.4 (A3); also elsewhere on the board
/FTDI/JTAG_TMS: U5.5 (A4); also elsewhere on the board
/~FAILED: U5.8 (A7); also elsewhere on the board
unnamed: D17.2 (A), J12.A4 (VBUS), J12.A9 (VBUS), J12.B4 (VBUS), J12.B9 (VBUS)
unnamed: J12.A5 (CC1), R10.1
unnamed: J12.B5 (CC2), R11.2
unnamed: R15.1, U3.3 (DI), U4.61 (EEDATA)
unnamed: R13.2, R15.2, U3.4 (DO)
unnamed: R14.2, U3.2 (SCLK), U4.62 (EECLK)
unnamed: U4.26 (ACBUS0), U5.19 (~OE)
unnamed: R18.1, U4.29 (ACBUS3)
unnamed: U4.16 (ADBUS0), U5.18 (B1)
unnamed: U4.17 (ADBUS1), U5.17 (B2)
unnamed: U4.18 (ADBUS2), U5.16 (B3)
unnamed: U4.19 (ADBUS3), U5.15 (B4)
unnamed: U4.21 (ADBUS4), U5.14 (B5)
unnamed: U4.22 (ADBUS5), U5.13 (B6)
unnamed: U4.23 (ADBUS6), U5.12 (B7)
unnamed: U4.24 (ADBUS7), U5.11 (B8)
unnamed: J12.A7 (D-), J12.B7 (D-), TP2.1 (1_1), U4.7 (DM)
unnamed: J12.A6 (D+), J12.B6 (D+), TP3.1 (1_1), U4.8 (DP)
unnamed: C8.1, U4.2 (OSCI), X1.1
unnamed: C11.1, TP4.1 (1_1), U4.3 (OSCO), X1.3
unnamed: R17.1, U4.6 (REF)
unnamed: C6.1, C9.1, FB2.2, U4.4 (VPHY)
unnamed: C3.1, C59.1, FB1.2, U4.9 (VPLL)
unnamed: R16.2, U4.14 (~RESET)
unnamed: U4.39 (BDBUS1), U14.2 (1A)
unnamed: U4.38 (BDBUS0), U14.3 (1B)
OGND: C2.2, C3.2, C4.2, C5.2, C6.2, C7.2, C8.2, C9.2, C10.2, C11.2, C12.2, C13.2, C14.2, C43.1, C59.2, J12.A1 (GND), J12.A12 (GND), J12.B1 (GND), J12.B12 (GND), J12.S1 (SHIELD), R10.2, R11.1, R17.2, R18.2, U3.5 (GND), U4.1 (GND), U4.5 (GND), U4.10 (AGND), U4.11 (GND), U4.13 (TEST), U4.15 (GND), U4.25 (GND), U4.35 (GND), U4.47 (GND), U4.51 (GND), U5.10 (GND), U14.1 (*1OE), U14.4 (GND), U14.7 (*2OE), X1.2, X1.4; also elsewhere on the board
OVDD: C43.2, U5.9 (A8), U5.20 (VCC), U14.8 (VCC); also elsewhere on the board
uart_rx: U14.6 (2B); also elsewhere on the board
uart_tx: U14.5 (2A); also elsewhere on the board

Notes on the sheet:
Fitering
FTDI Configuration

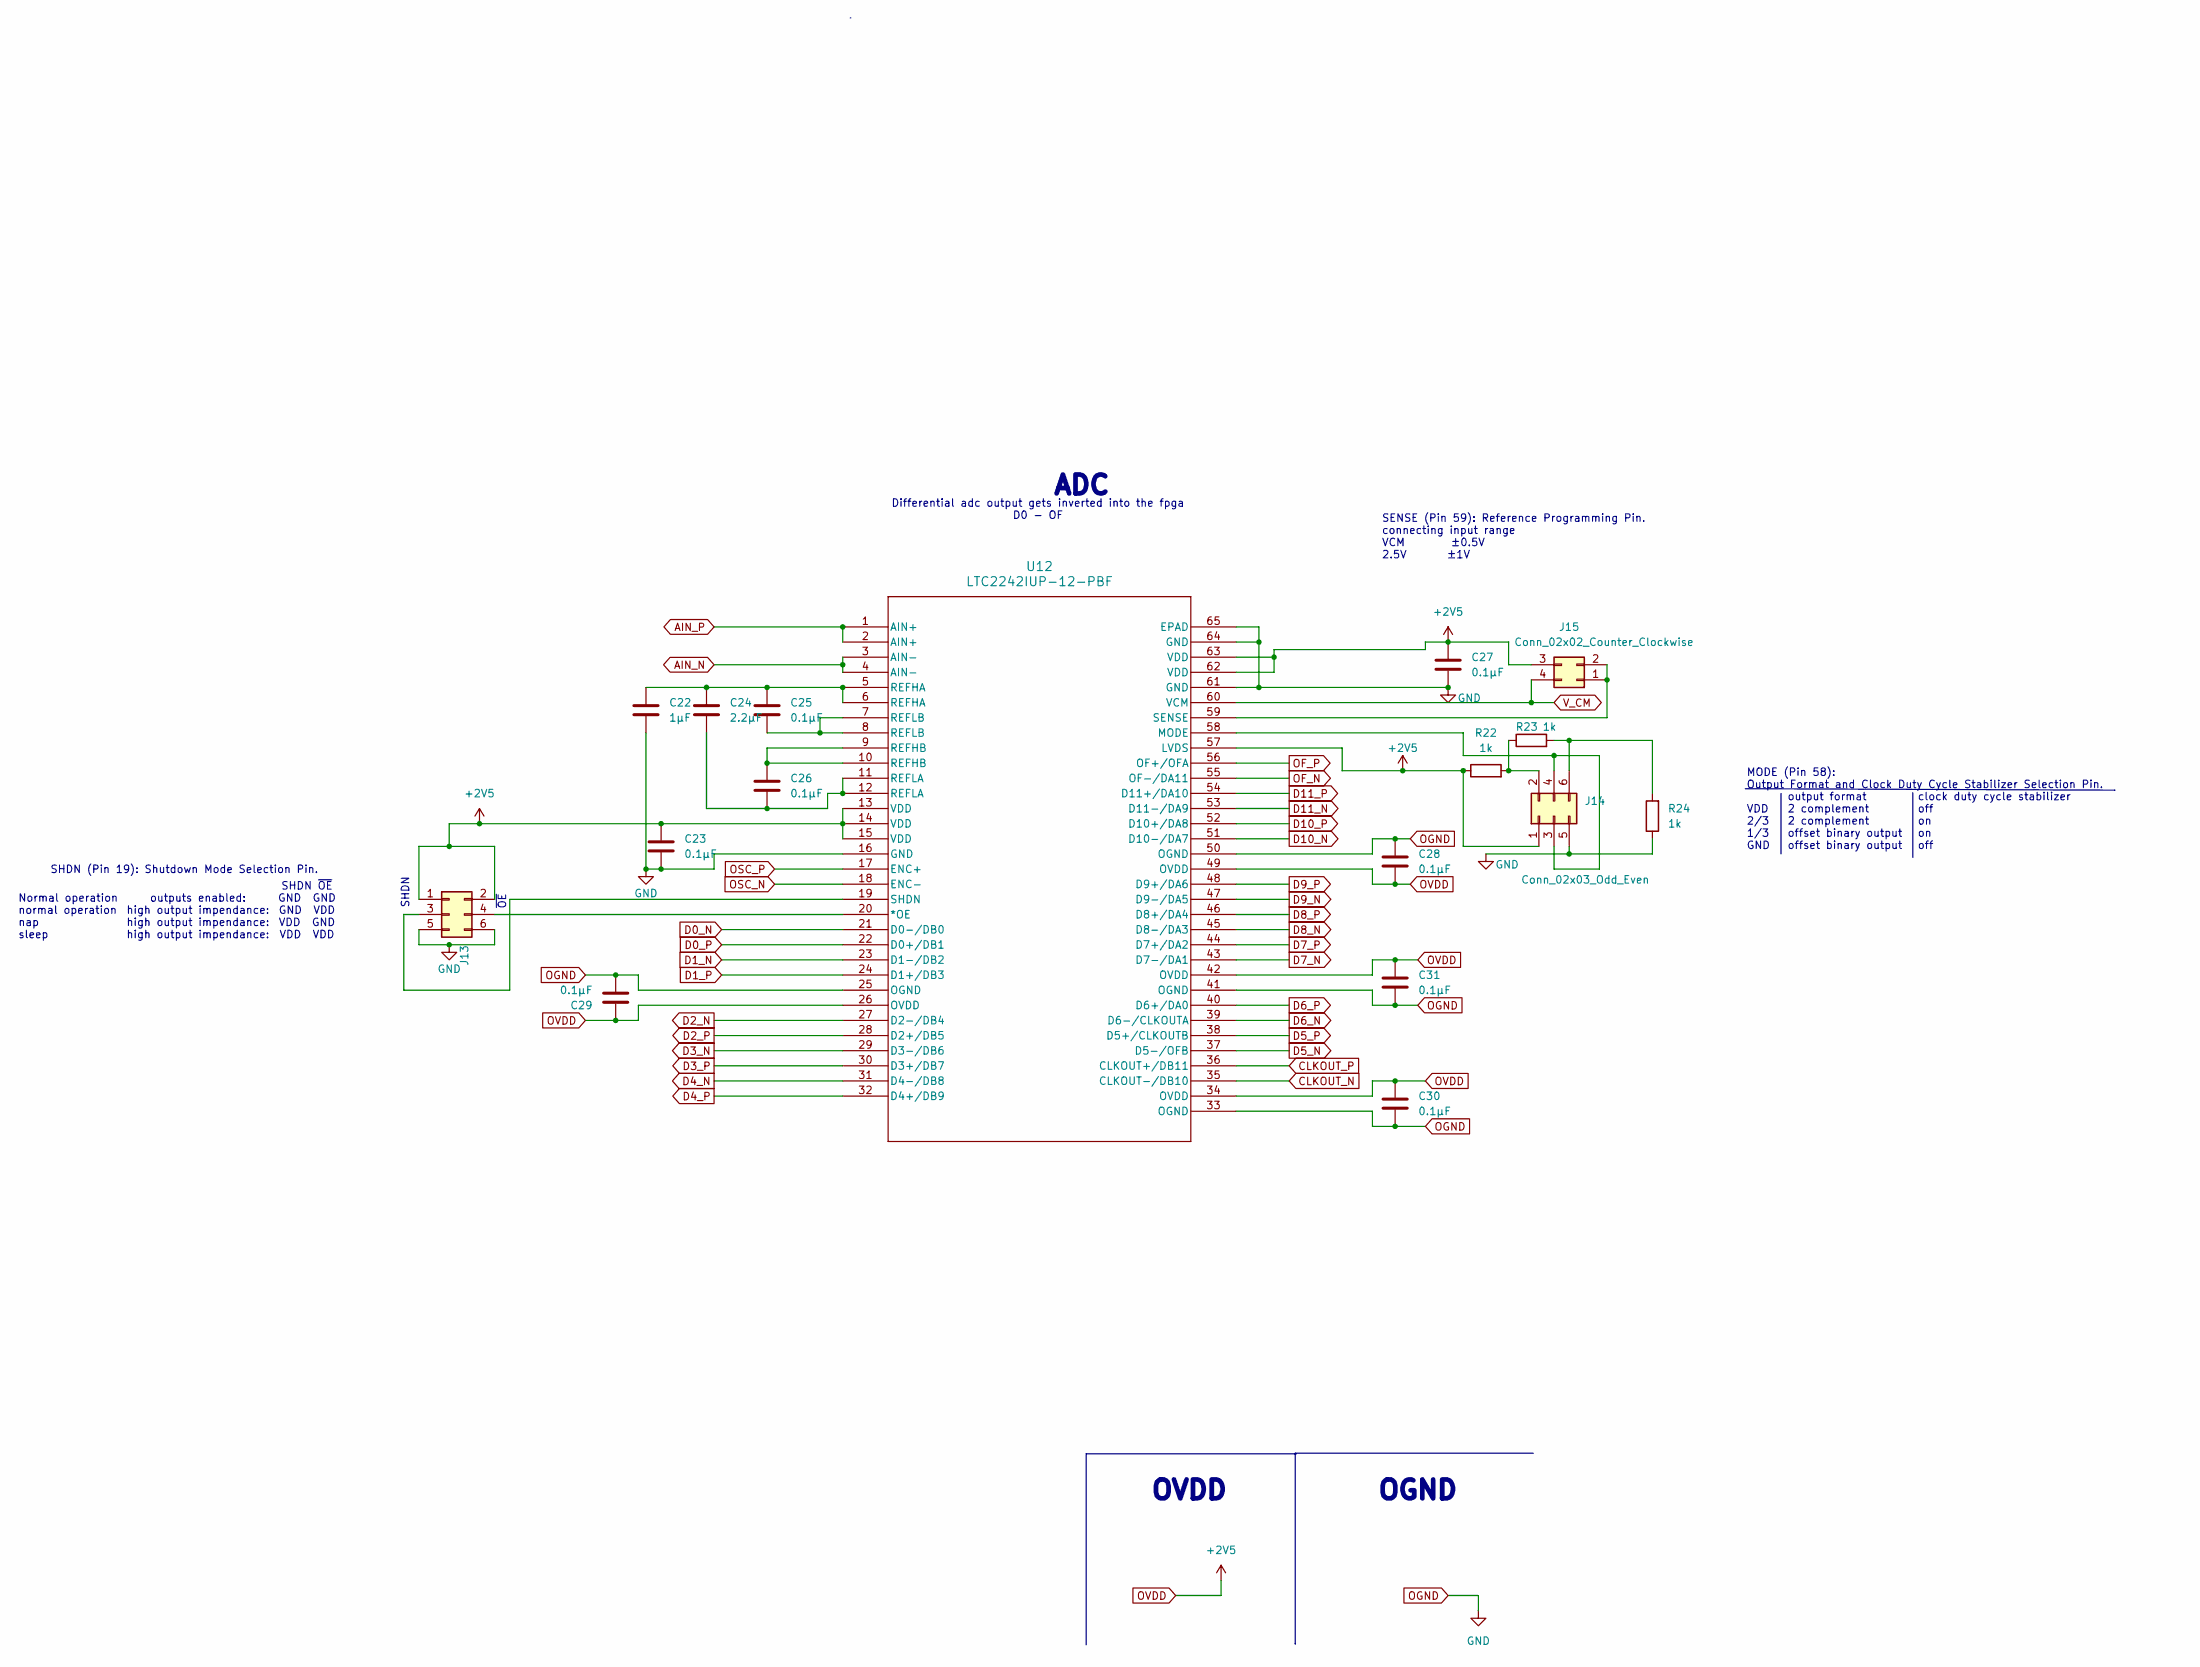
[picture p8: schematic adc.kicad_sch, SoM Programmer & ADC Board]

Parts:
C22: 1μF; C_0603_1608Metric; DigiKey_no 399-C0603C105K4RACTUCT-ND
C23, C25, C26, C27, C28, C29, C30, C31: 0.1μF; C_0603_1608Metric; DigiKey_no 399-C0603X103J4HACAUTOCT-ND
C24: 2.2μF; C_0603_1608Metric; DigiKey_no 1276-1040-1-ND
J13, J14: Conn_02x03_Odd_Even; PinHeader_2x03_P2.54mm_Vertical; DigiKey_no 609-3234-ND
J15: Conn_02x02_Counter_Clockwise; PinHeader_2x02_P2.54mm_Vertical; DigiKey_no 609-3233-ND
R22, R23, R24: 1k; R_0603_1608Metric; DigiKey_no 541-1.00KHCT-ND
U12: LTC2242IUP-12-PBF; QFN-64_UP_LIT; DigiKey_no LTC2242IUP-12#PBF-ND

Connections:
AIN_N: U12.3 (AIN-), U12.4 (AIN-); also elsewhere on the board
AIN_P: U12.1 (AIN+), U12.2 (AIN+); also elsewhere on the board
CLKOUT_N: U12.35 (CLKOUT-/DB10); also elsewhere on the board
CLKOUT_P: U12.36 (CLKOUT+/DB11); also elsewhere on the board
D0_N: U12.21 (D0-/DB0); also elsewhere on the board
D0_P: U12.22 (D0+/DB1); also elsewhere on the board
D1_N: U12.23 (D1-/DB2); also elsewhere on the board
D1_P: U12.24 (D1+/DB3); also elsewhere on the board
D2_N: U12.27 (D2-/DB4); also elsewhere on the board
D2_P: U12.28 (D2+/DB5); also elsewhere on the board
D3_N: U12.29 (D3-/DB6); also elsewhere on the board
D3_P: U12.30 (D3+/DB7); also elsewhere on the board
D4_N: U12.31 (D4-/DB8); also elsewhere on the board
D4_P: U12.32 (D4+/DB9); also elsewhere on the board
D5_N: U12.37 (D5-/OFB); also elsewhere on the board
D5_P: U12.38 (D5+/CLKOUTB); also elsewhere on the board
D6_N: U12.39 (D6-/CLKOUTA); also elsewhere on the board
D6_P: U12.40 (D6+/DA0); also elsewhere on the board
D7_N: U12.43 (D7-/DA1); also elsewhere on the board
D7_P: U12.44 (D7+/DA2); also elsewhere on the board
D8_N: U12.45 (D8-/DA3); also elsewhere on the board
D8_P: U12.46 (D8+/DA4); also elsewhere on the board
D9_N: U12.47 (D9-/DA5); also elsewhere on the board
D9_P: U12.48 (D9+/DA6); also elsewhere on the board
D10_N: U12.51 (D10-/DA7); also elsewhere on the board
D10_P: U12.52 (D10+/DA8); also elsewhere on the board
D11_N: U12.53 (D11-/DA9); also elsewhere on the board
D11_P: U12.54 (D11+/DA10); also elsewhere on the board
unnamed: C22.1, C24.1, C25.1, U12.5 (REFHA), U12.6 (REFHA)
unnamed: C24.2, C26.2, U12.11 (REFLA), U12.12 (REFLA)
unnamed: C25.2, U12.7 (REFLB), U12.8 (REFLB)
unnamed: C26.1, U12.9 (REFHB), U12.10 (REFHB)
unnamed: J13.3, U12.19 (SHDN)
unnamed: J13.4, U12.20 (*OE)
unnamed: J14.2, R22.2, R23.1
unnamed: J14.3, J14.4, U12.58 (MODE)
unnamed: J14.6, R23.2, R24.2
unnamed: J15.1, J15.2, U12.59 (SENSE)
OF_N: U12.55 (OF-/DA11); also elsewhere on the board
OF_P: U12.56 (OF+/OFA); also elsewhere on the board
OGND: C22.2, C23.2, C27.1, C28.1, C29.1, C30.2, C31.2, J13.5, J13.6, J14.5, R24.1, U12.16 (GND), U12.25 (OGND), U12.33 (OGND), U12.41 (OGND), U12.50 (OGND), U12.61 (GND), U12.64 (GND), U12.65 (EPAD); also elsewhere on the board
OSC_N: U12.18 (ENC-); also elsewhere on the board
OSC_P: U12.17 (ENC+); also elsewhere on the board
OVDD: C23.1, C27.2, C28.2, C29.2, C30.1, C31.1, J13.1, J13.2, J14.1, J15.3, R22.1, U12.13 (VDD), U12.14 (VDD), U12.15 (VDD), U12.26 (OVDD), U12.34 (OVDD), U12.42 (OVDD), U12.49 (OVDD), U12.57 (LVDS), U12.62 (VDD), U12.63 (VDD); also elsewhere on the board
V_CM: J15.4, U12.60 (VCM); also elsewhere on the board

Notes on the sheet:
SENSE (Pin 59): Reference Programming Pin. connecting input range VCM ±0.5V 2.5V ±1V
Normal operation normal operation nap sleep
OGND
SHDN
OVDD
SHDN ~{OE} GND GND GND VDD VDD GND VDD VDD
SHDN (Pin 19): Shutdown Mode Selection Pin.
Differential adc output gets inverted into the fpga D0 - OF
ADC
MODE (Pin 58): Output Format and Clock Duty Cycle Stabilizer Selection Pin. VDD 2/3 1/3 GND
outputs enabled: high output impendance: high output impendance: high output impendance:
output format 2 complement 2 complement offset binary output offset binary output
~{OE}
clock duty cycle stabilizer off on on off

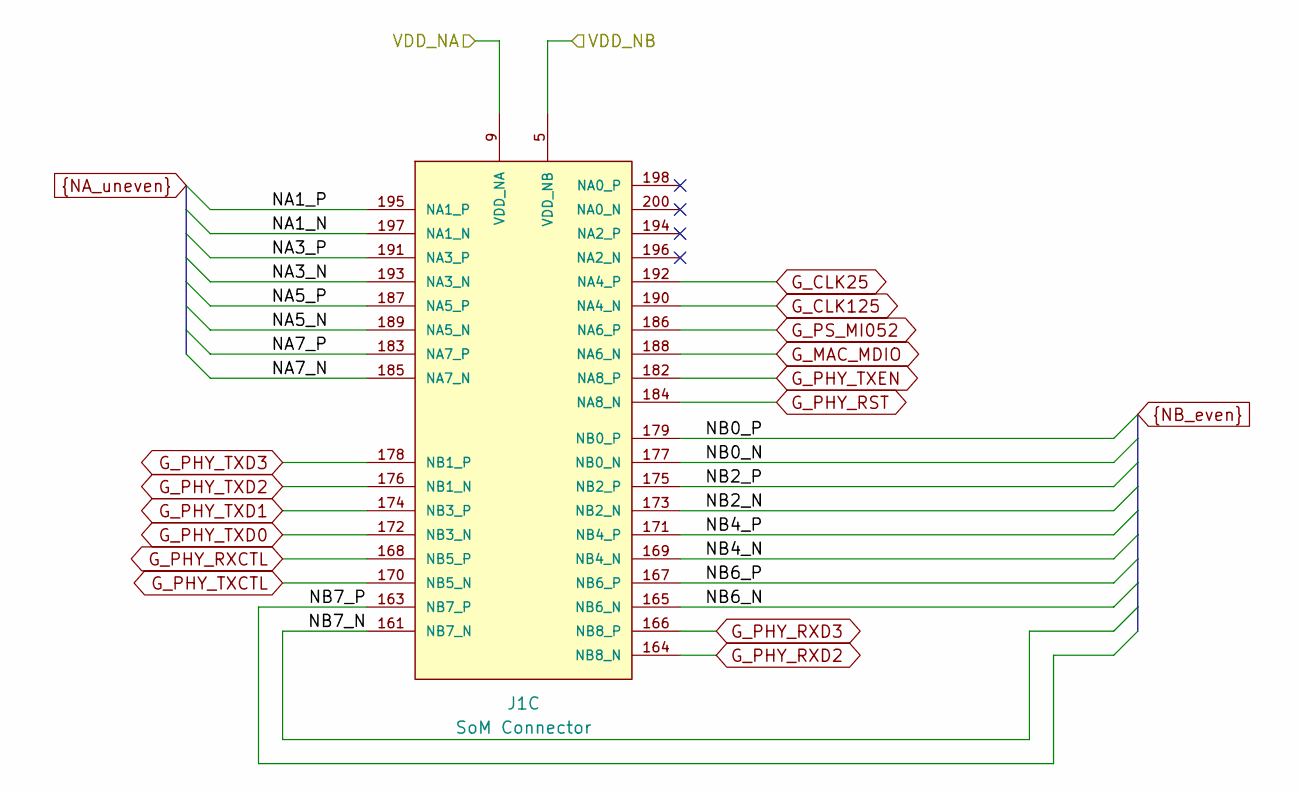
[picture p9: schematic Northbank.kicad_sch, SoM Programmer & ADC Board]

Parts:
J1: SoM Connector; SoM_Connector; Mouser Part Number 571-1-1473005-1

Connections:
/Header Interface/Northbank/VDD_NA: J1.9 (VDD_NA); also elsewhere on the board
/Header Interface/Northbank/VDD_NB: J1.5 (VDD_NB); also elsewhere on the board
G_CLK25: J1.192 (NA4_P); also elsewhere on the board
G_CLK125: J1.190 (NA4_N); also elsewhere on the board
G_MAC_MDIO: J1.188 (NA6_N); also elsewhere on the board
G_PHY_RST: J1.184 (NA8_N); also elsewhere on the board
G_PHY_RXCTL: J1.168 (NB5_P); also elsewhere on the board
G_PHY_RXD2: J1.164 (NB8_N); also elsewhere on the board
G_PHY_RXD3: J1.166 (NB8_P); also elsewhere on the board
G_PHY_TXCTL: J1.170 (NB5_N); also elsewhere on the board
G_PHY_TXD0: J1.172 (NB3_N); also elsewhere on the board
G_PHY_TXD1: J1.174 (NB3_P); also elsewhere on the board
G_PHY_TXD2: J1.176 (NB1_N); also elsewhere on the board
G_PHY_TXD3: J1.178 (NB1_P); also elsewhere on the board
G_PHY_TXEN: J1.182 (NA8_P); also elsewhere on the board
G_PS_MI052: J1.186 (NA6_P); also elsewhere on the board
NA1_N: J1.197 (NA1_N); also elsewhere on the board
NA1_P: J1.195 (NA1_P); also elsewhere on the board
NA3_N: J1.193 (NA3_N); also elsewhere on the board
NA3_P: J1.191 (NA3_P); also elsewhere on the board
NA5_N: J1.189 (NA5_N); also elsewhere on the board
NA5_P: J1.187 (NA5_P); also elsewhere on the board
NA7_N: J1.185 (NA7_N); also elsewhere on the board
NA7_P: J1.183 (NA7_P); also elsewhere on the board
NB0_N: J1.177 (NB0_N); also elsewhere on the board
NB0_P: J1.179 (NB0_P); also elsewhere on the board
NB2_N: J1.173 (NB2_N); also elsewhere on the board
NB2_P: J1.175 (NB2_P); also elsewhere on the board
NB4_N: J1.169 (NB4_N); also elsewhere on the board
NB4_P: J1.171 (NB4_P); also elsewhere on the board
NB6_N: J1.165 (NB6_N); also elsewhere on the board
NB6_P: J1.167 (NB6_P); also elsewhere on the board
NB7_N: J1.161 (NB7_N); also elsewhere on the board
NB7_P: J1.163 (NB7_P); also elsewhere on the board

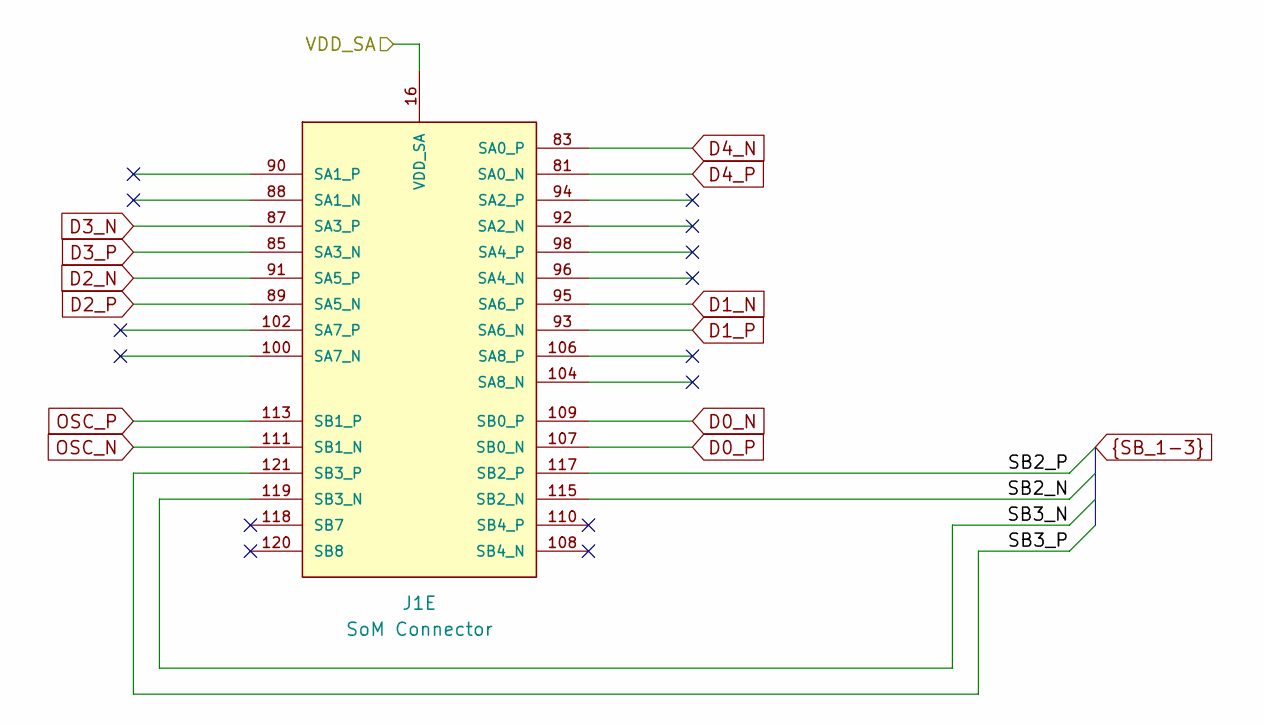
[picture p10: schematic Southbank.kicad_sch, SoM Programmer & ADC Board]

Parts:
J1: SoM Connector; SoM_Connector; Mouser Part Number 571-1-1473005-1

Connections:
/Header Interface/Southbank/VDD_SA: J1.16 (VDD_SA); also elsewhere on the board
D0_N: J1.109 (SB0_P); also elsewhere on the board
D0_P: J1.107 (SB0_N); also elsewhere on the board
D1_N: J1.95 (SA6_P); also elsewhere on the board
D1_P: J1.93 (SA6_N); also elsewhere on the board
D2_N: J1.91 (SA5_P); also elsewhere on the board
D2_P: J1.89 (SA5_N); also elsewhere on the board
D3_N: J1.87 (SA3_P); also elsewhere on the board
D3_P: J1.85 (SA3_N); also elsewhere on the board
D4_N: J1.83 (SA0_P); also elsewhere on the board
D4_P: J1.81 (SA0_N); also elsewhere on the board
OSC_N: J1.111 (SB1_N); also elsewhere on the board
OSC_P: J1.113 (SB1_P); also elsewhere on the board
SB2_N: J1.115 (SB2_N); also elsewhere on the board
SB2_P: J1.117 (SB2_P); also elsewhere on the board
SB3_N: J1.119 (SB3_N); also elsewhere on the board
SB3_P: J1.121 (SB3_P); also elsewhere on the board

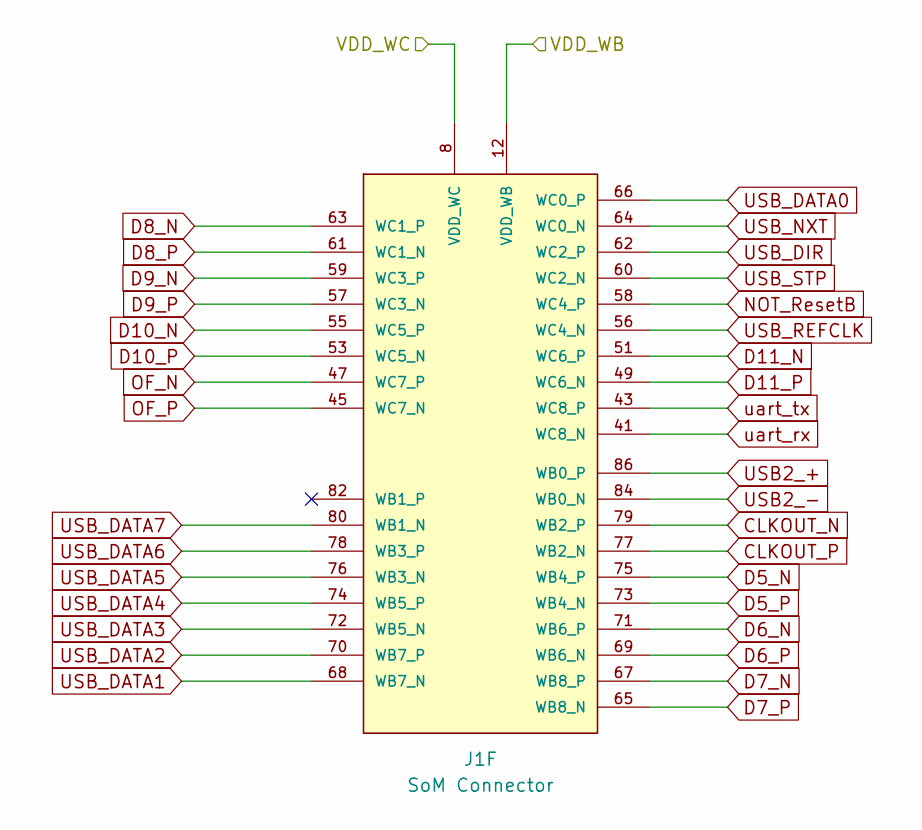
[picture p11: schematic Westbank.kicad_sch, SoM Programmer & ADC Board]

Parts:
J1: SoM Connector; SoM_Connector; Mouser Part Number 571-1-1473005-1

Connections:
/Header Interface/Westbank/VDD_WB: J1.12 (VDD_WB); also elsewhere on the board
/Header Interface/Westbank/VDD_WC: J1.8 (VDD_WC); also elsewhere on the board
CLKOUT_N: J1.79 (WB2_P); also elsewhere on the board
CLKOUT_P: J1.77 (WB2_N); also elsewhere on the board
D5_N: J1.75 (WB4_P); also elsewhere on the board
D5_P: J1.73 (WB4_N); also elsewhere on the board
D6_N: J1.71 (WB6_P); also elsewhere on the board
D6_P: J1.69 (WB6_N); also elsewhere on the board
D7_N: J1.67 (WB8_P); also elsewhere on the board
D7_P: J1.65 (WB8_N); also elsewhere on the board
D8_N: J1.63 (WC1_P); also elsewhere on the board
D8_P: J1.61 (WC1_N); also elsewhere on the board
D9_N: J1.59 (WC3_P); also elsewhere on the board
D9_P: J1.57 (WC3_N); also elsewhere on the board
D10_N: J1.55 (WC5_P); also elsewhere on the board
D10_P: J1.53 (WC5_N); also elsewhere on the board
D11_N: J1.51 (WC6_P); also elsewhere on the board
D11_P: J1.49 (WC6_N); also elsewhere on the board
NOT_ResetB: J1.58 (WC4_P); also elsewhere on the board
OF_N: J1.47 (WC7_P); also elsewhere on the board
OF_P: J1.45 (WC7_N); also elsewhere on the board
USB2_+: J1.86 (WB0_P); also elsewhere on the board
USB2_-: J1.84 (WB0_N); also elsewhere on the board
USB_DATA0: J1.66 (WC0_P); also elsewhere on the board
USB_DATA1: J1.68 (WB7_N); also elsewhere on the board
USB_DATA2: J1.70 (WB7_P); also elsewhere on the board
USB_DATA3: J1.72 (WB5_N); also elsewhere on the board
USB_DATA4: J1.74 (WB5_P); also elsewhere on the board
USB_DATA5: J1.76 (WB3_N); also elsewhere on the board
USB_DATA6: J1.78 (WB3_P); also elsewhere on the board
USB_DATA7: J1.80 (WB1_N); also elsewhere on the board
USB_DIR: J1.62 (WC2_P); also elsewhere on the board
USB_NXT: J1.64 (WC0_N); also elsewhere on the board
USB_REFCLK: J1.56 (WC4_N); also elsewhere on the board
USB_STP: J1.60 (WC2_N); also elsewhere on the board
uart_rx: J1.41 (WC8_N); also elsewhere on the board
uart_tx: J1.43 (WC8_P); also elsewhere on the board

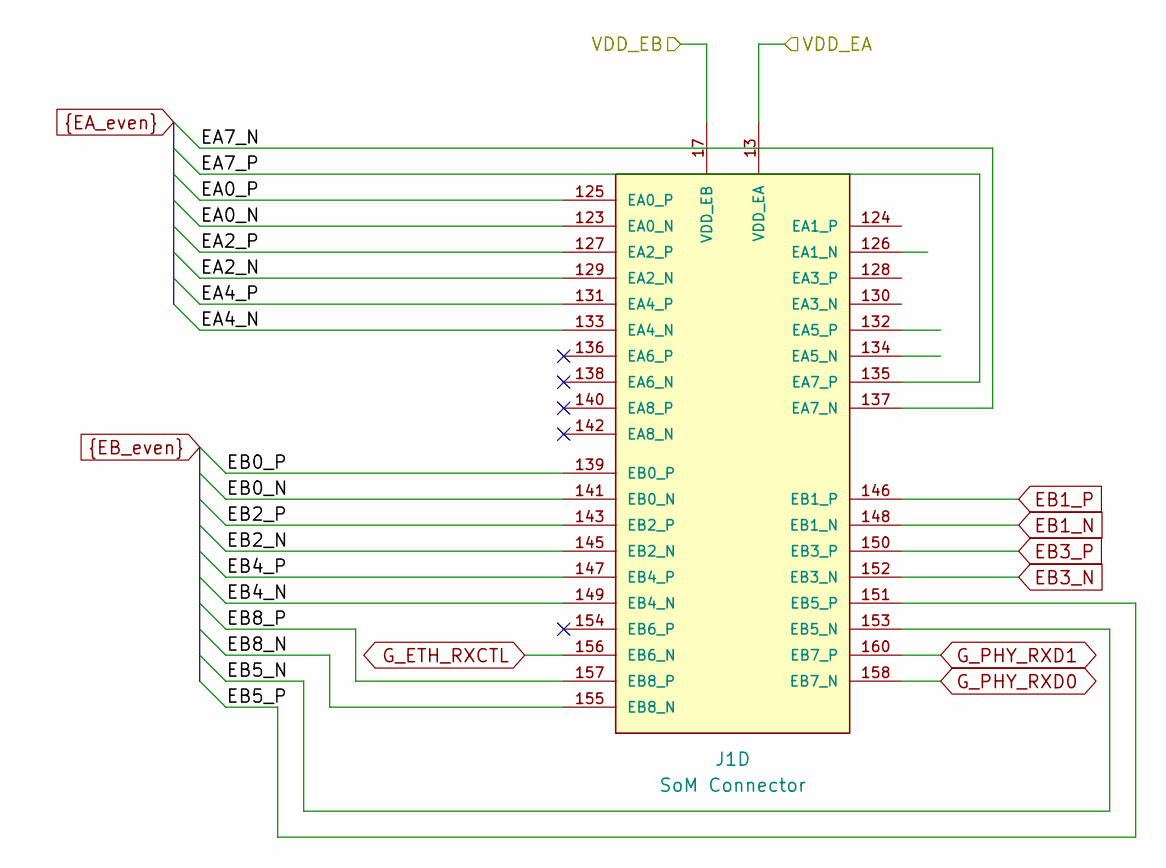
[picture p12: schematic Eastbank.kicad_sch, SoM Programmer & ADC Board]

Parts:
J1: SoM Connector; SoM_Connector; Mouser Part Number 571-1-1473005-1

Connections:
/Header Interface/Eastbank/VDD_EA: J1.13 (VDD_EA); also elsewhere on the board
/Header Interface/Eastbank/VDD_EB: J1.17 (VDD_EB); also elsewhere on the board
EA0_N: J1.123 (EA0_N); also elsewhere on the board
EA0_P: J1.125 (EA0_P); also elsewhere on the board
EA2_N: J1.129 (EA2_N); also elsewhere on the board
EA2_P: J1.127 (EA2_P); also elsewhere on the board
EA4_N: J1.133 (EA4_N); also elsewhere on the board
EA4_P: J1.131 (EA4_P); also elsewhere on the board
EA7_N: J1.137 (EA7_N); also elsewhere on the board
EA7_P: J1.135 (EA7_P); also elsewhere on the board
EB0_N: J1.141 (EB0_N); also elsewhere on the board
EB0_P: J1.139 (EB0_P); also elsewhere on the board
EB1_N: J1.148 (EB1_N); also elsewhere on the board
EB1_P: J1.146 (EB1_P); also elsewhere on the board
EB2_N: J1.145 (EB2_N); also elsewhere on the board
EB2_P: J1.143 (EB2_P); also elsewhere on the board
EB3_N: J1.152 (EB3_N); also elsewhere on the board
EB3_P: J1.150 (EB3_P); also elsewhere on the board
EB4_N: J1.149 (EB4_N)
EB4_P: J1.147 (EB4_P)
EB5_N: J1.153 (EB5_N); also elsewhere on the board
EB5_P: J1.151 (EB5_P); also elsewhere on the board
EB8_N: J1.155 (EB8_N); also elsewhere on the board
EB8_P: J1.157 (EB8_P); also elsewhere on the board
G_ETH_RXCTL: J1.156 (EB6_N); also elsewhere on the board
G_PHY_RXD0: J1.158 (EB7_N); also elsewhere on the board
G_PHY_RXD1: J1.160 (EB7_P); also elsewhere on the board

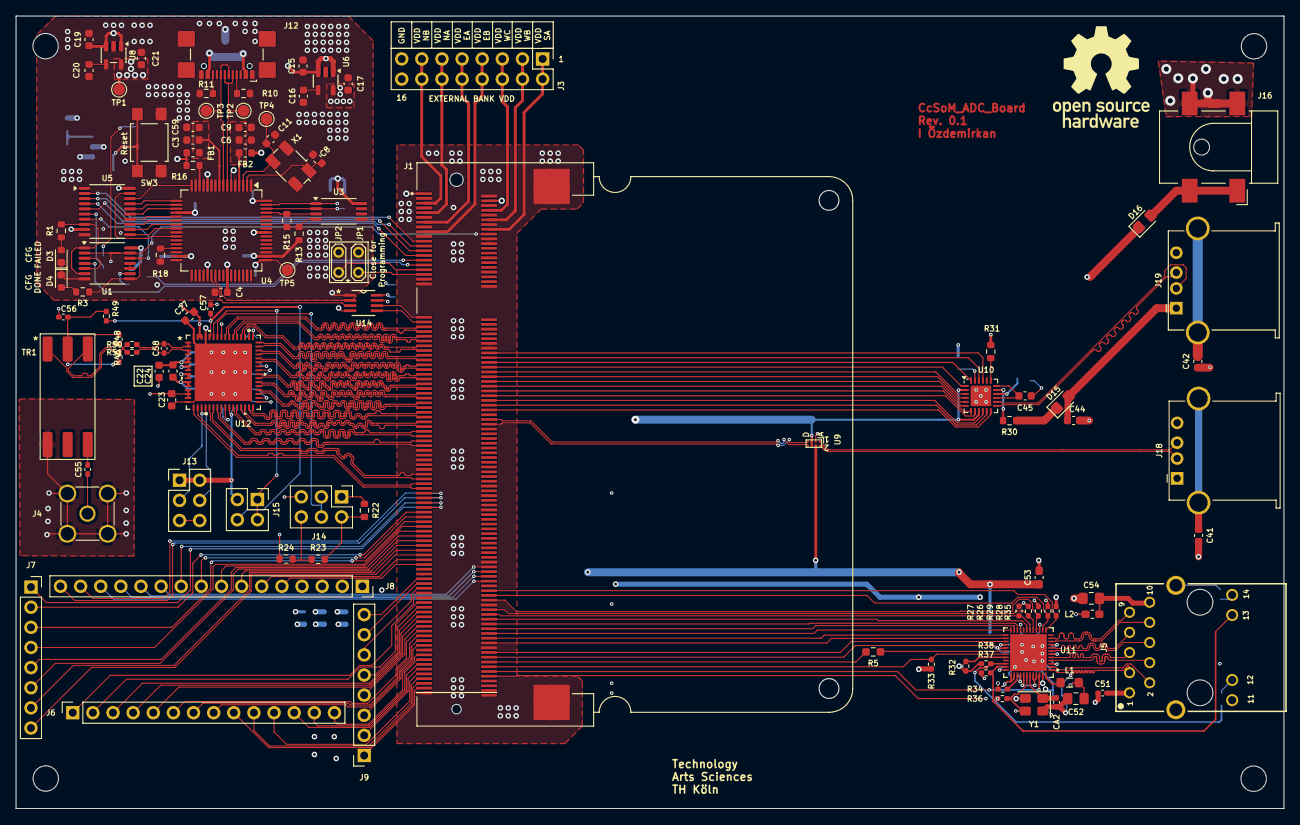
[picture p13: board CcSoM_ADC_Board.kicad_pcb from above]

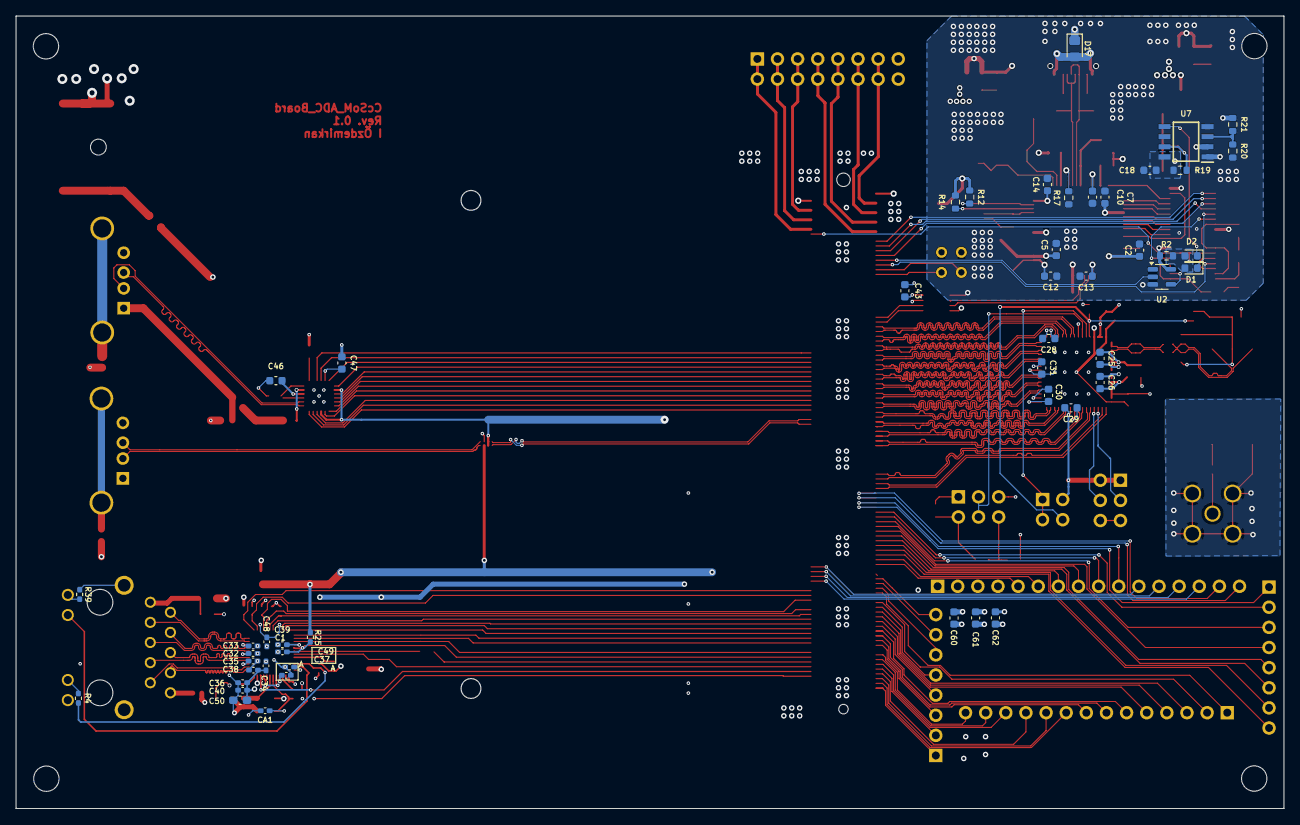
[picture p14: board CcSoM_ADC_Board.kicad_pcb from below]

Board: 4 copper layers, 160.0 x 100.0 mm, 159 parts (49 on the bottom side), 220 nets.
