isoeth/CcSoM_ADC_Board/(commit log)

2026-01-28 init push
    [CcSoM_ADC_Board.kicad_pcb, CcSoM_ADC_Board.kicad_sch, Eastbank.kicad_sch, FTDI.kicad_sch, HeaderInterface.kicad_sch, Northbank.kicad_sch, PowerSupply.kicad_sch, Southbank.kicad_sch]
2026-02-09 changed from 10Bit ADC to 12Bit
    [CcSoM_ADC_Board.kicad_pcb, CcSoM_ADC_Board.kicad_sch, Eastbank.kicad_sch, HeaderInterface.kicad_sch, Southbank.kicad_sch, Westbank.kicad_sch, adc.kicad_sch, analog_front_end.kicad_sch]
2026-02-09 corrected schematic created pdf and bom file
    [CcSoM_ADC_Board.kicad_sch, Eastbank.kicad_sch, FTDI.kicad_sch, HeaderInterface.kicad_sch, Northbank.kicad_sch, PowerSupply.kicad_sch, Southbank.kicad_sch, Westbank.kicad_sch]
2026-02-09 changed some traces
    [CcSoM_ADC_Board.kicad_pcb]
2026-02-25 moved designator and changed vddio to 2.5V
    [CcSoM_ADC_Board.kicad_pcb, usb2.kicad_sch]
2026-03-04 last before rotating adc
    [CcSoM_ADC_Board.kicad_pcb, CcSoM_ADC_Board.kicad_sch, Eastbank.kicad_sch, Westbank.kicad_sch, usb2.kicad_sch]
2026-03-04 added kicad .gitignore
2026-03-04 changed schottky, began to add digikey part numbers
    [CcSoM_ADC_Board.kicad_pcb, CcSoM_ADC_Board.kicad_sch, FTDI.kicad_sch, PowerSupply.kicad_sch, adc.kicad_sch, analog_front_end.kicad_sch, gigabit_ethernet.kicad_sch, usb2.kicad_sch]
2026-03-11 digikey no not complete
    [CcSoM_ADC_Board.kicad_pcb, CcSoM_ADC_Board.kicad_sch, Eastbank.kicad_sch, FTDI.kicad_sch, HeaderInterface.kicad_sch, Northbank.kicad_sch, PowerSupply.kicad_sch, Southbank.kicad_sch]
2026-03-13 changed library path added symbols and footprints
    [CcSoM_ADC_Board.kicad_pcb, gigabit_ethernet.kicad_sch]
2026-03-13 added datasheets deleted duplicate footprints
2026-03-16 changed footprint of pinheader from smd to through hole
    [CcSoM_ADC_Board.kicad_pcb, adc.kicad_sch]
2026-03-16 changed digikeyno from component, added info into readme about discontinued parts in digikey
    [CcSoM_ADC_Board.kicad_pcb, adc.kicad_sch, analog_front_end.kicad_sch, usb2.kicad_sch]
2026-04-01 corrected differential pairs
    [CcSoM_ADC_Board.kicad_pcb, CcSoM_ADC_Board.kicad_sch, Eastbank.kicad_sch, FTDI.kicad_sch, HeaderInterface.kicad_sch, Northbank.kicad_sch, PowerSupply.kicad_sch, Southbank.kicad_sch]
2026-04-01 added pcb name on F.Mask
    [CcSoM_ADC_Board.kicad_pcb]
2026-04-17 changed traces
    [CcSoM_ADC_Board.kicad_pcb]
2026-04-17 added gerber files and other changes
    [CcSoM_ADC_Board.kicad_pcb, Eastbank.kicad_sch, PowerSupply.kicad_sch, Southbank.kicad_sch, Westbank.kicad_sch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]
