isoeth/CcSoM_ADC_Board/(notices)

Notices in the files:
CcSoM_ADC_Board/gigabit_ethernet.kicad_sch:
GPL-3.0
